Jurrie/Z99-development/Book/README.md

# Build Your Own Four-Axis Multifunctional Z99 CNC Machine

The Z99 is documented in the book ['Build Your Own Four-Axis Multifunctional Z99 CNC Machine'](https://www.elektormagazine.com/articles/build-your-own-4-axis-multifunctional-z99-cnc-machine) by José Ganseman.
It was published December 26th 2022 by Elektor magazine.

Please consider buying the book!
It is available as a [hard copy](https://www.elektor.com/tools/prototyping/etching-milling/build-your-own-multifunctional-4-axis-cnc-machine) or an [e-book](https://www.elektor.com/books/e-books/build-your-own-multifunctional-4-axis-cnc-machine-e-book).

These are the preview pages that are available on [Issuu](https://issuu.com/eimworld/docs/4-axis-cnc-machine-extract).
They were converted to images by using [IssuuDownload.com](https://issuudownload.com/eimworld/docs/4-axis-cnc-machine-extract).

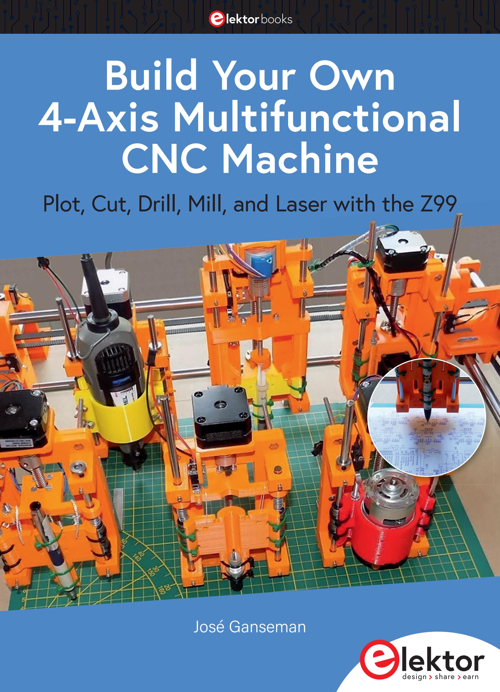
[picture p2: Book/page_01.jpg]




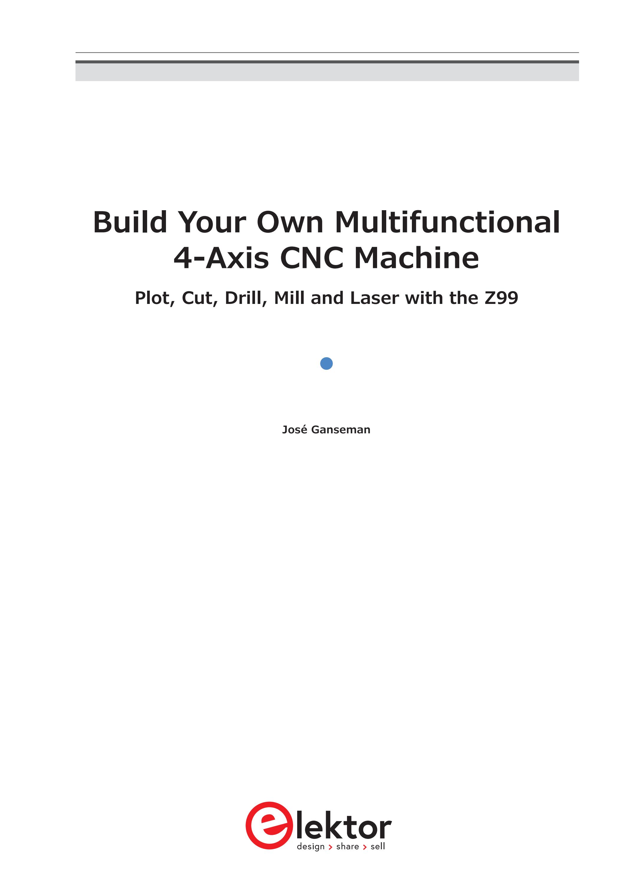
[picture p3: Book/page_03.jpg]


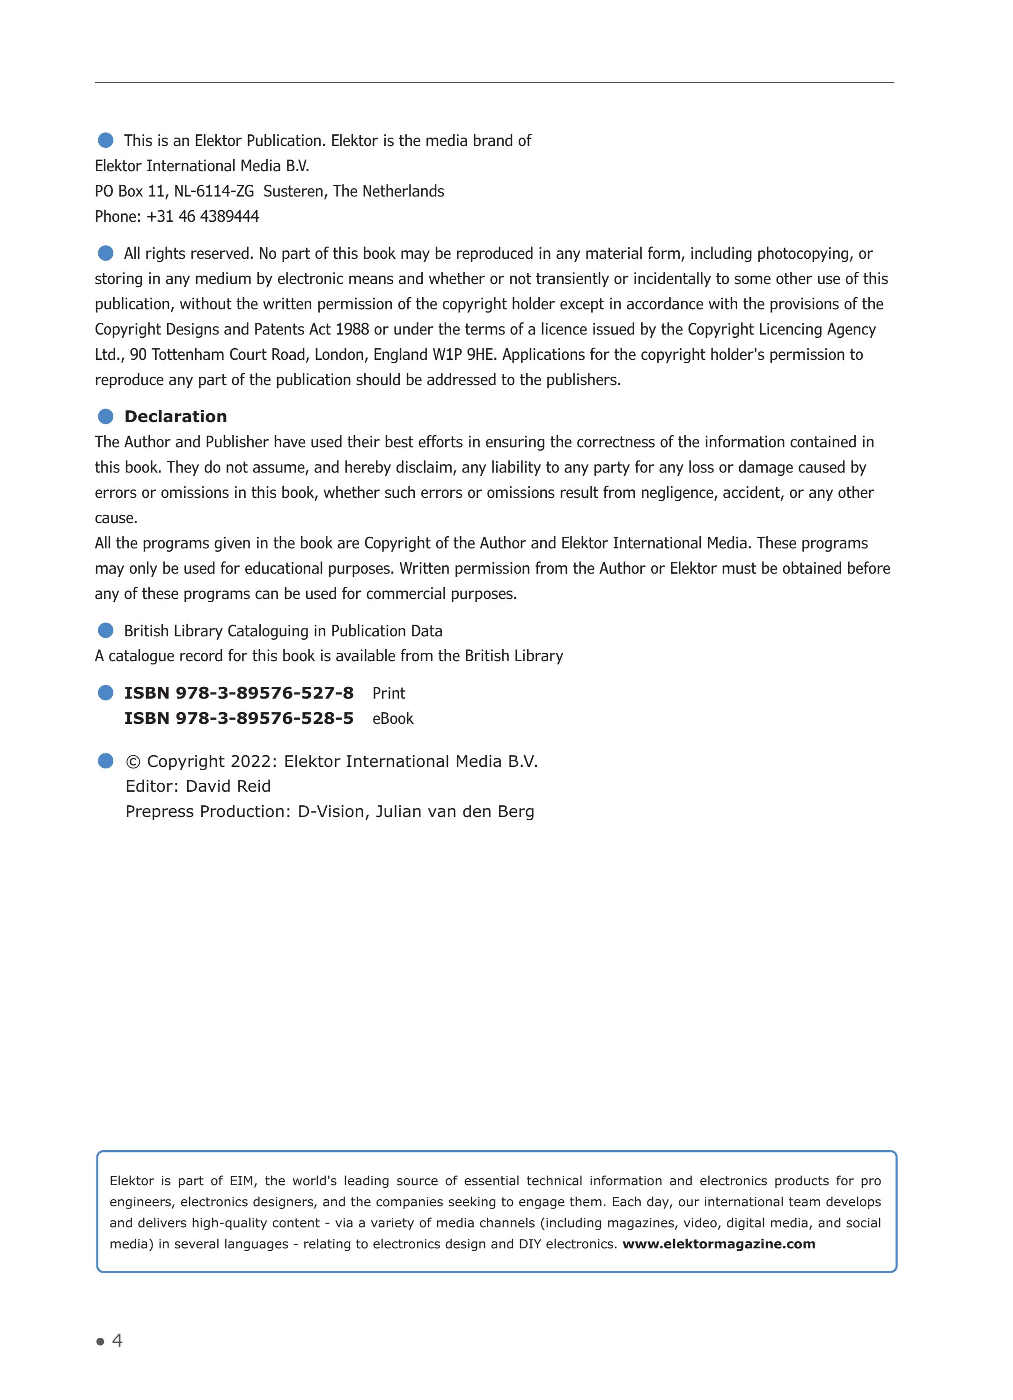
[picture p4: Book/page_04.jpg]


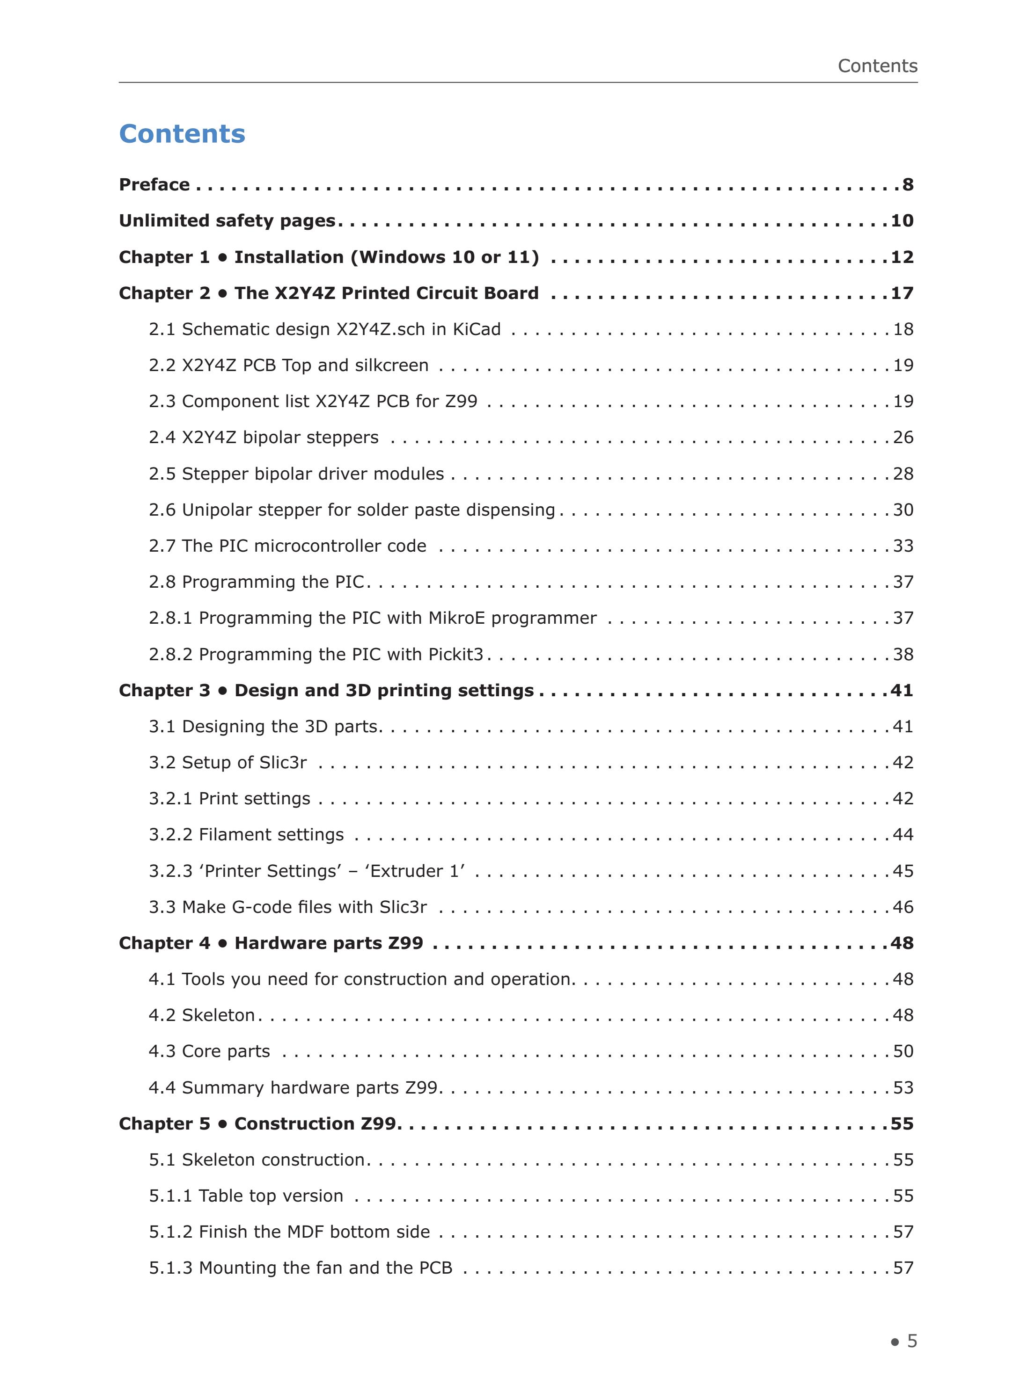
[picture p5: Book/page_05.jpg]


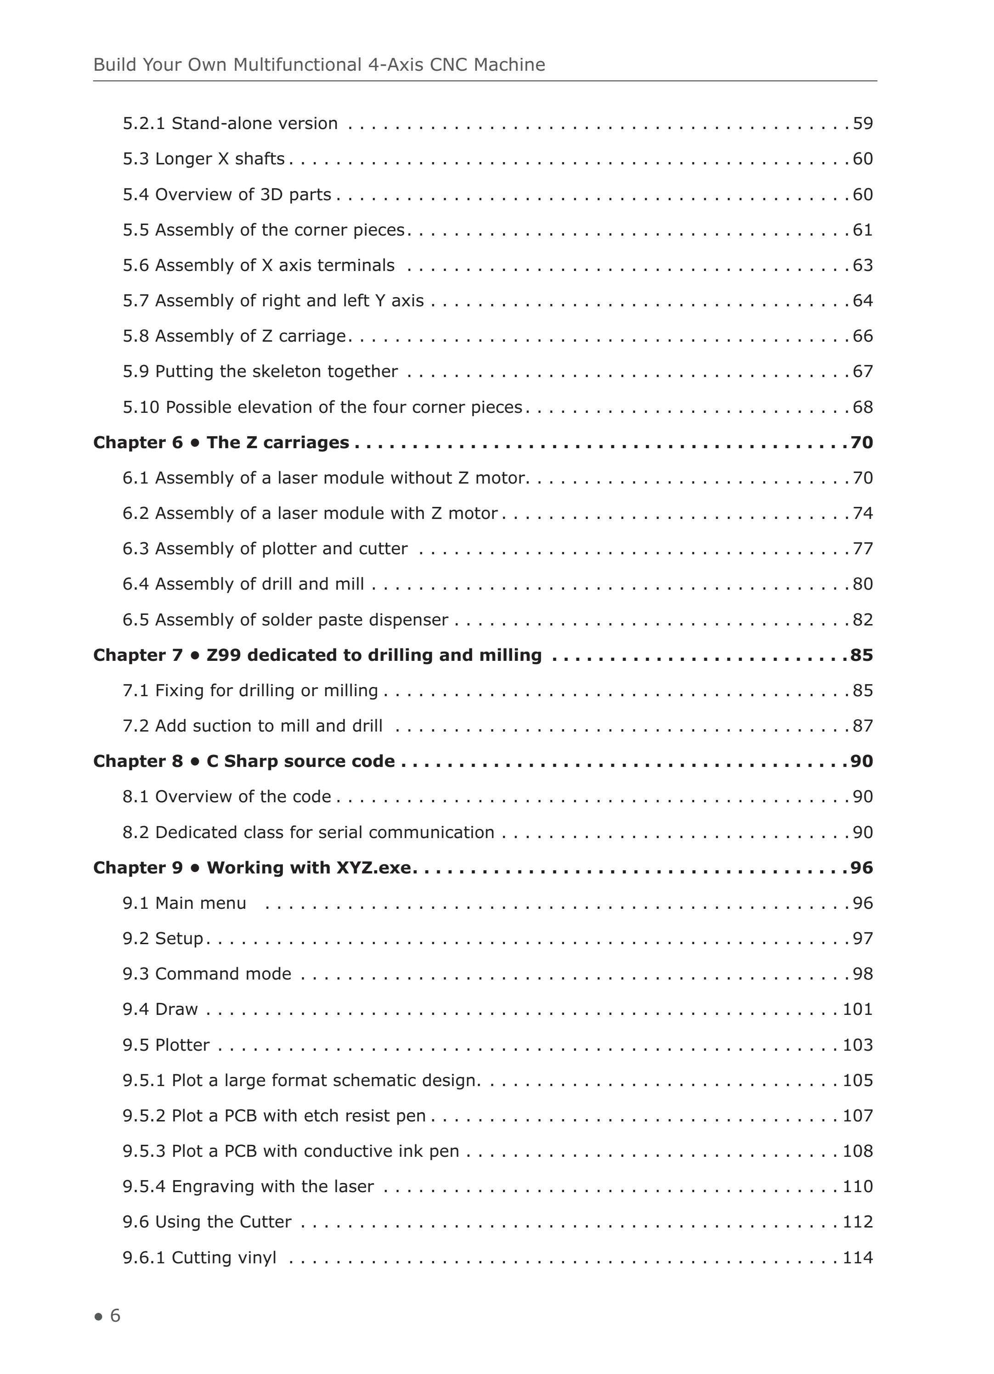
[picture p6: Book/page_06.jpg]


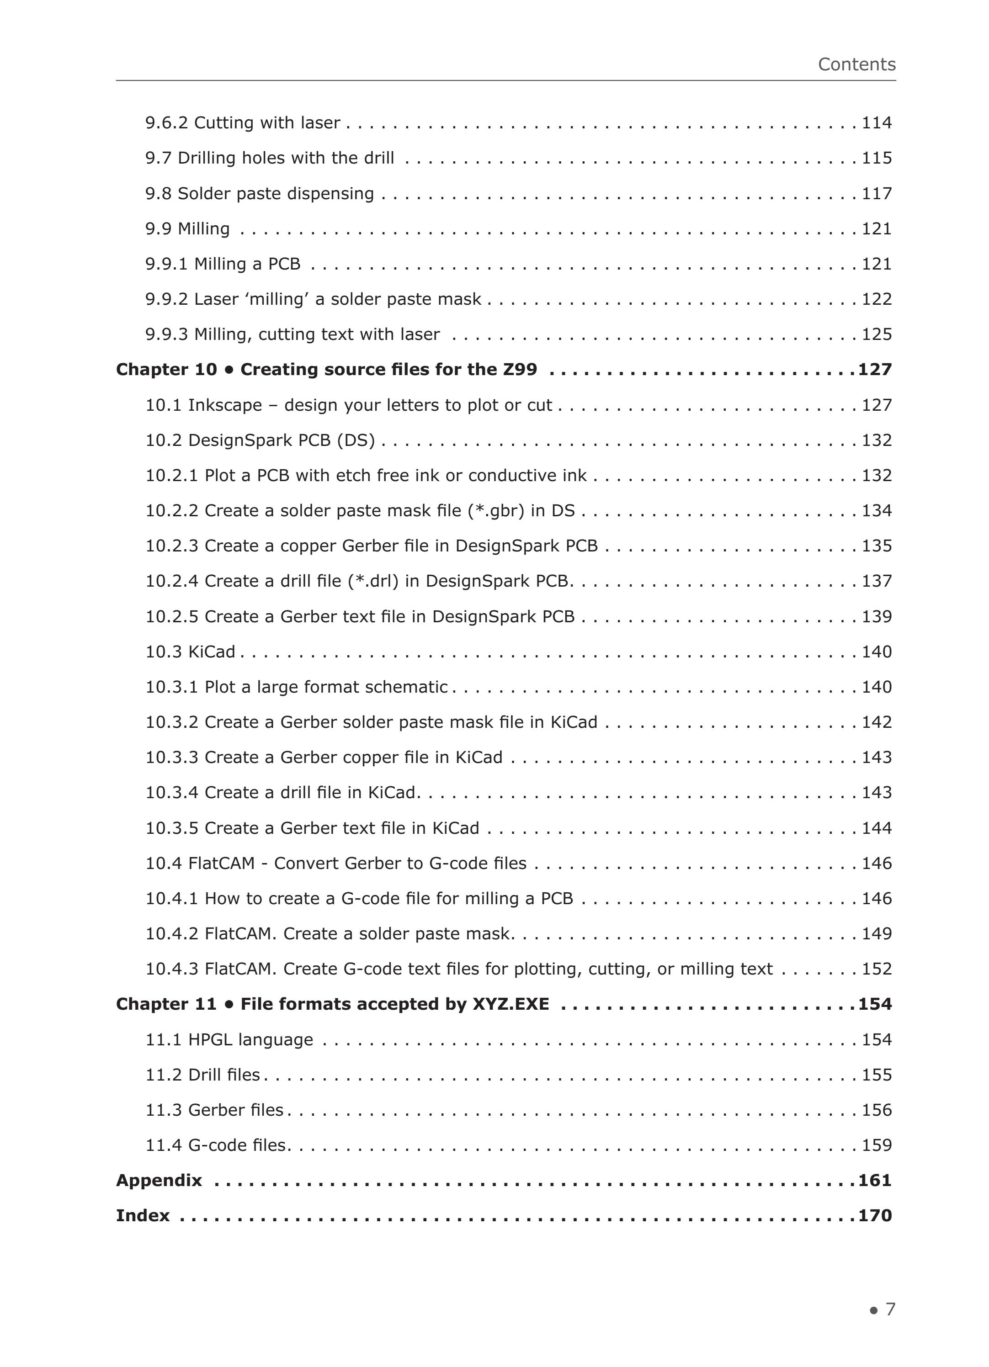
[picture p7: Book/page_07.jpg]


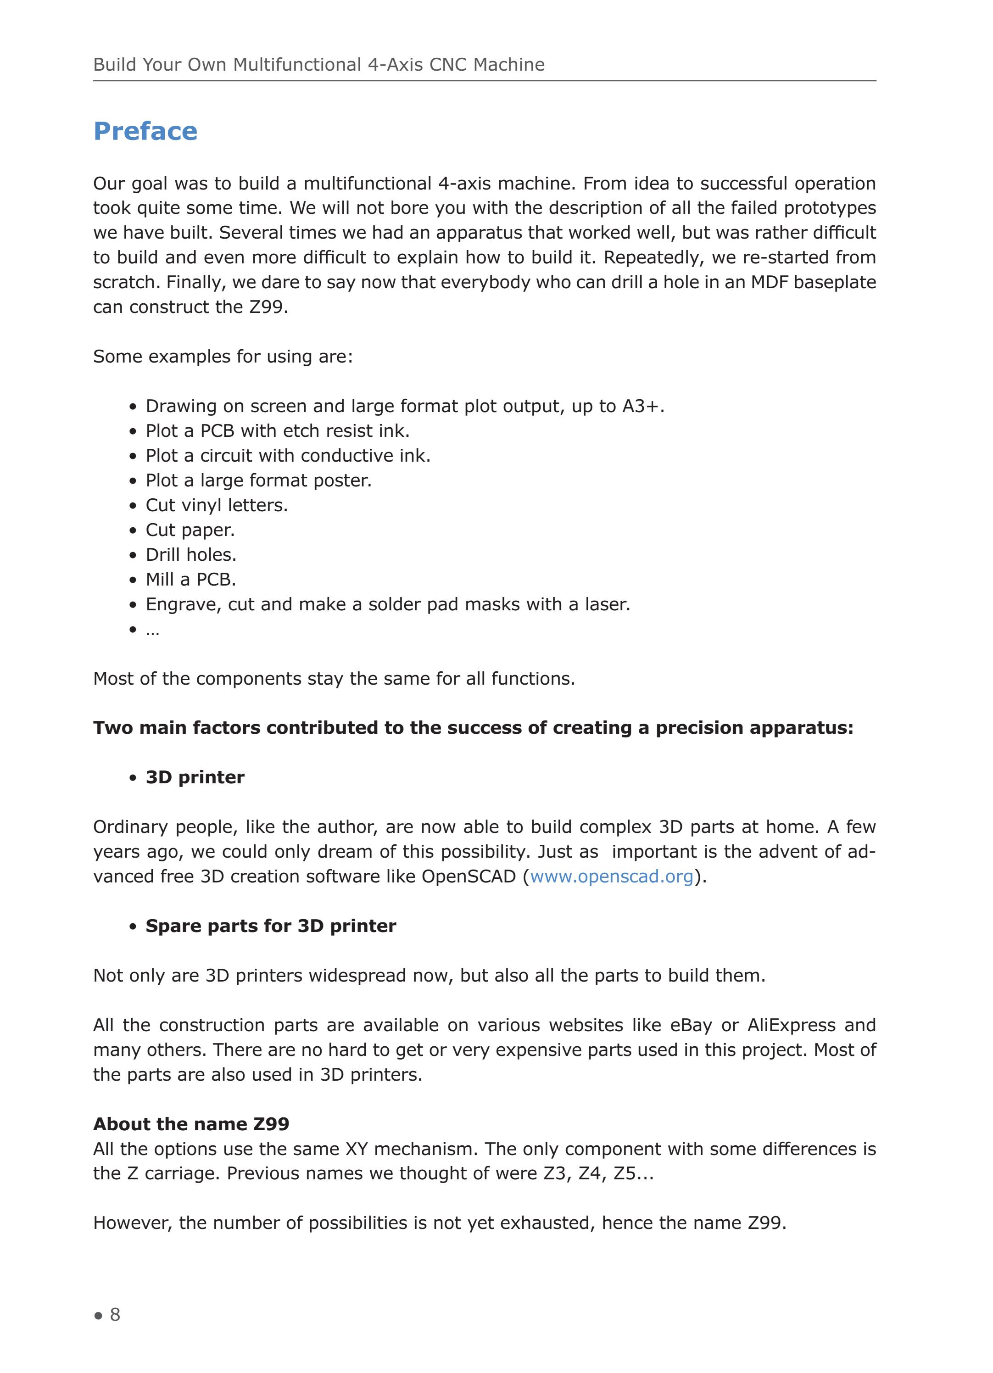
[picture p8: Book/page_08.jpg]


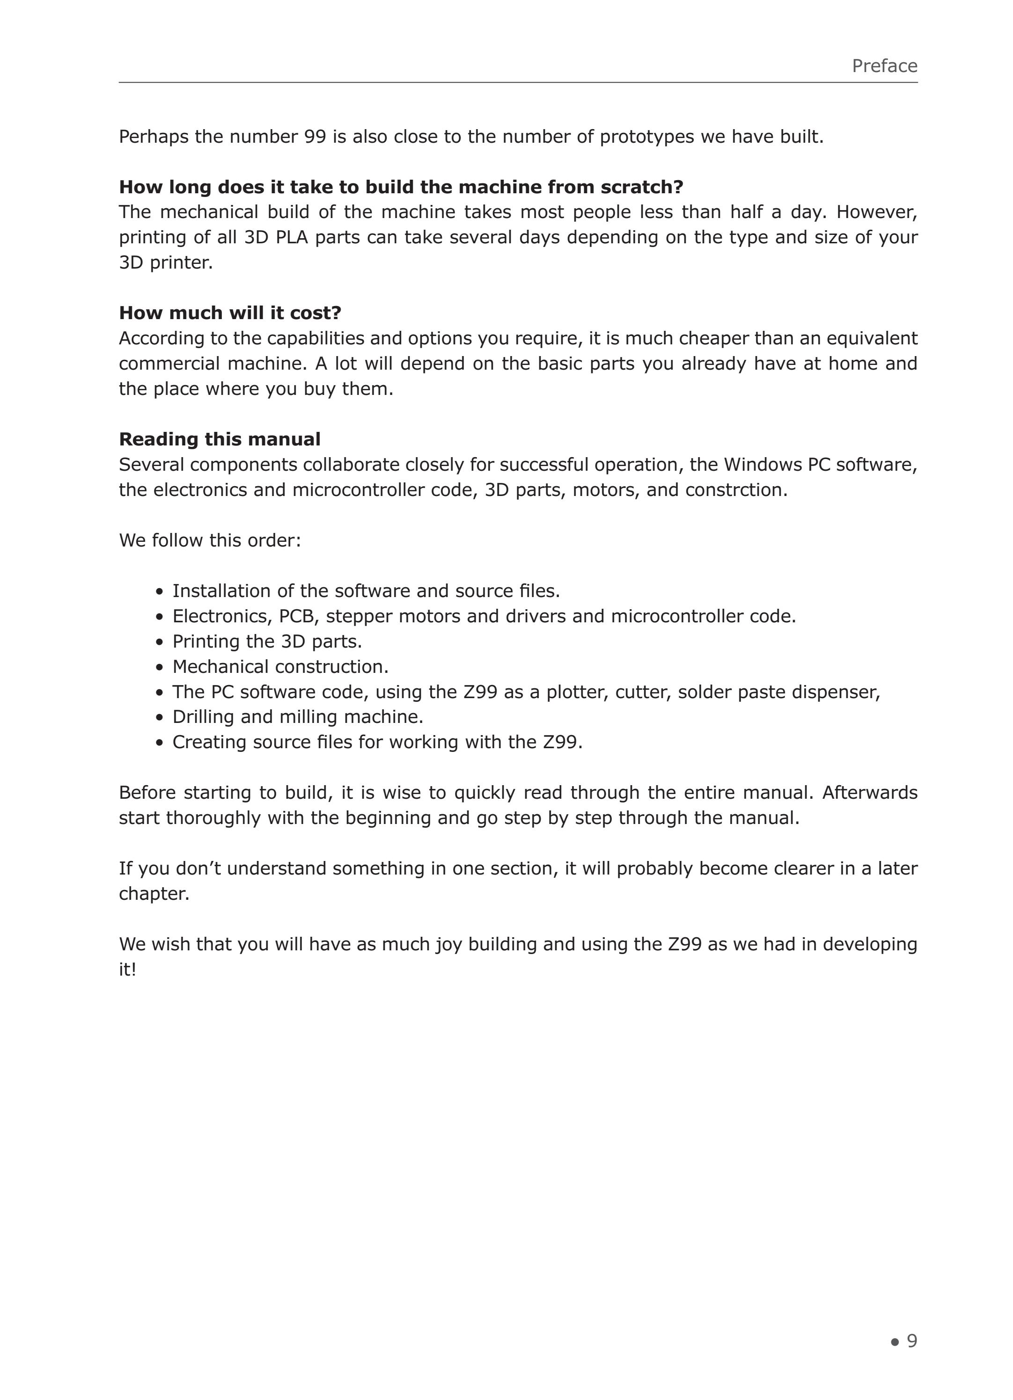
[picture p9: Book/page_09.jpg]


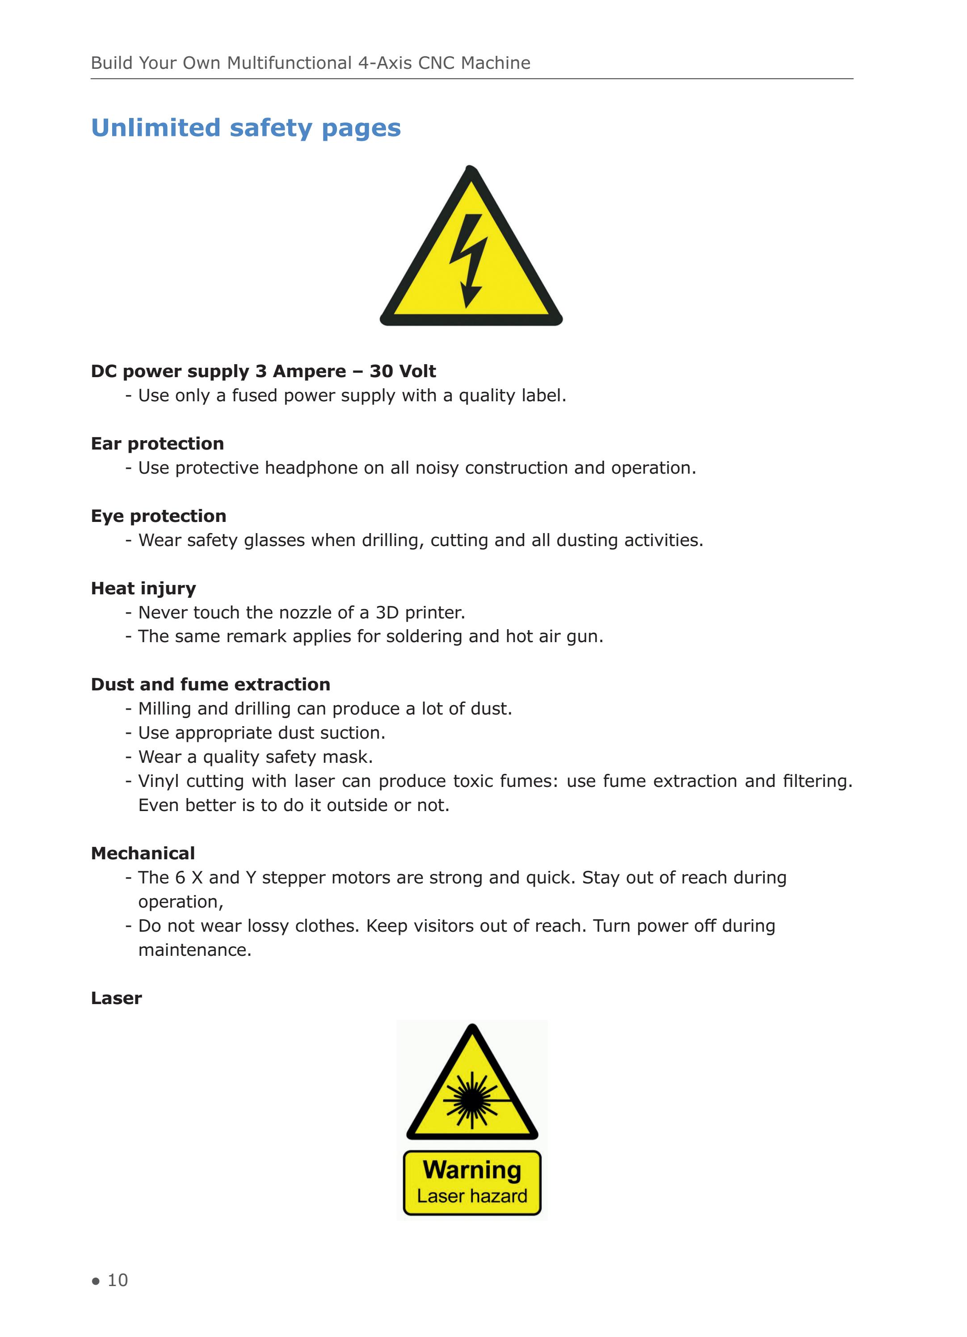
[picture p10: Book/page_10.jpg]


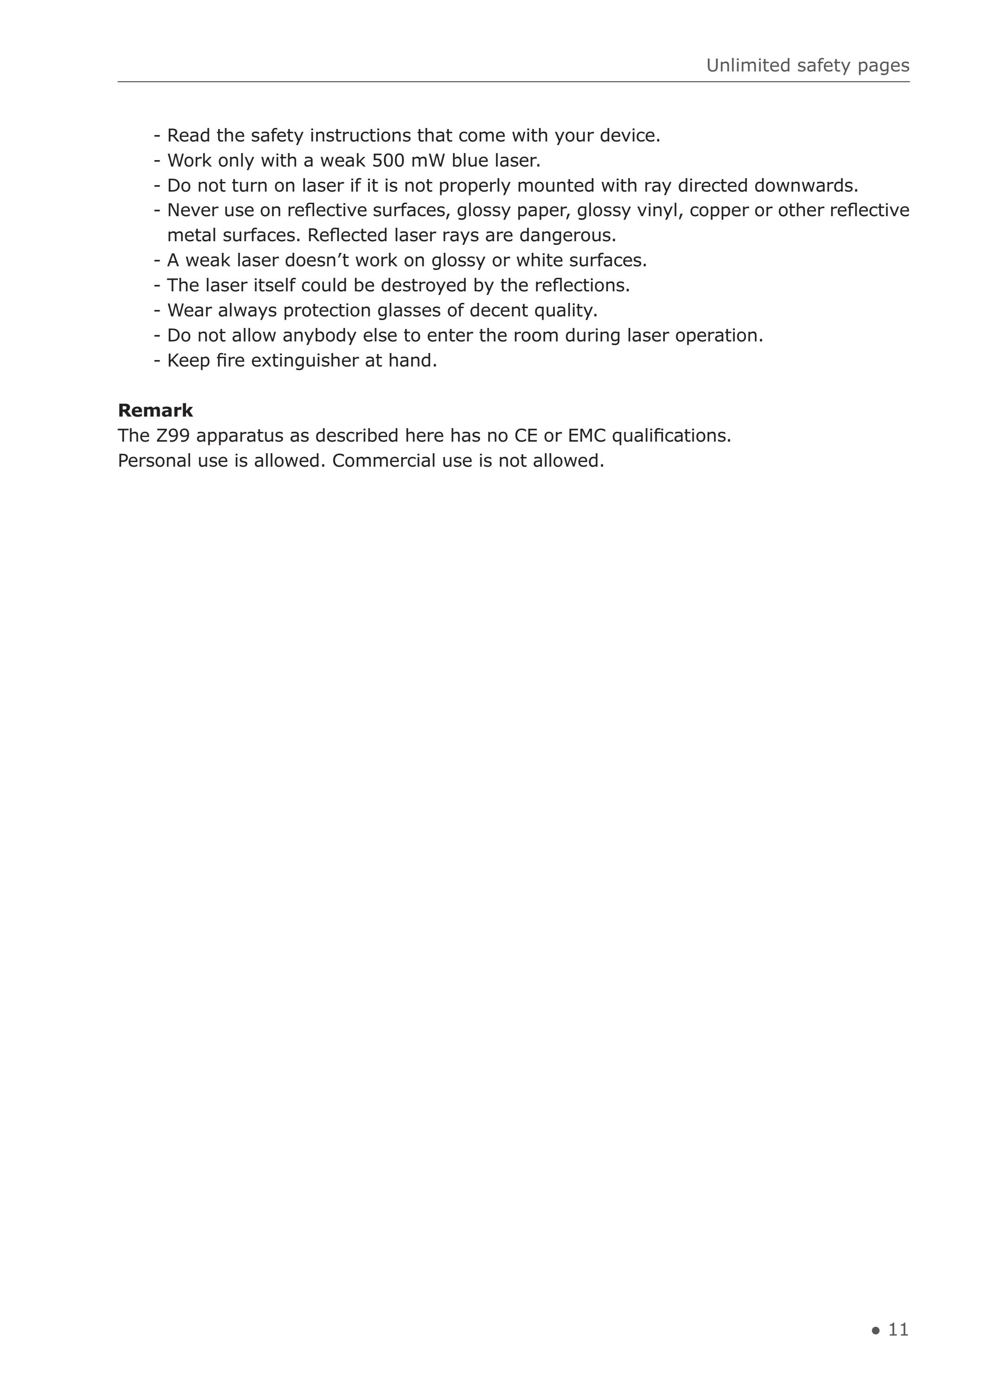
[picture p11: Book/page_11.jpg]


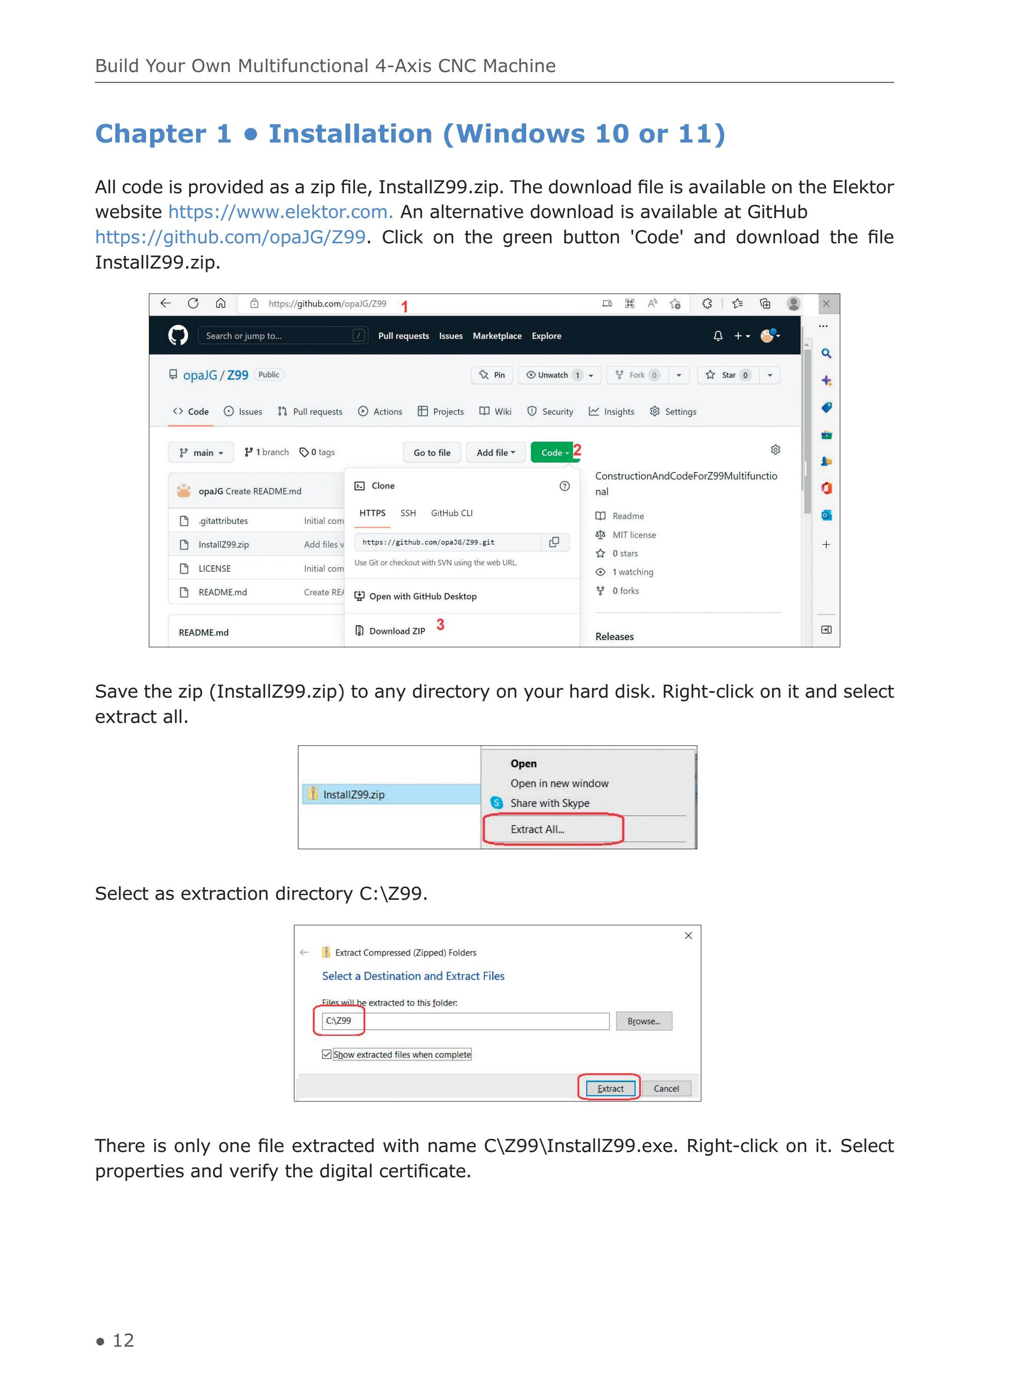
[picture p12: Book/page_12.jpg]


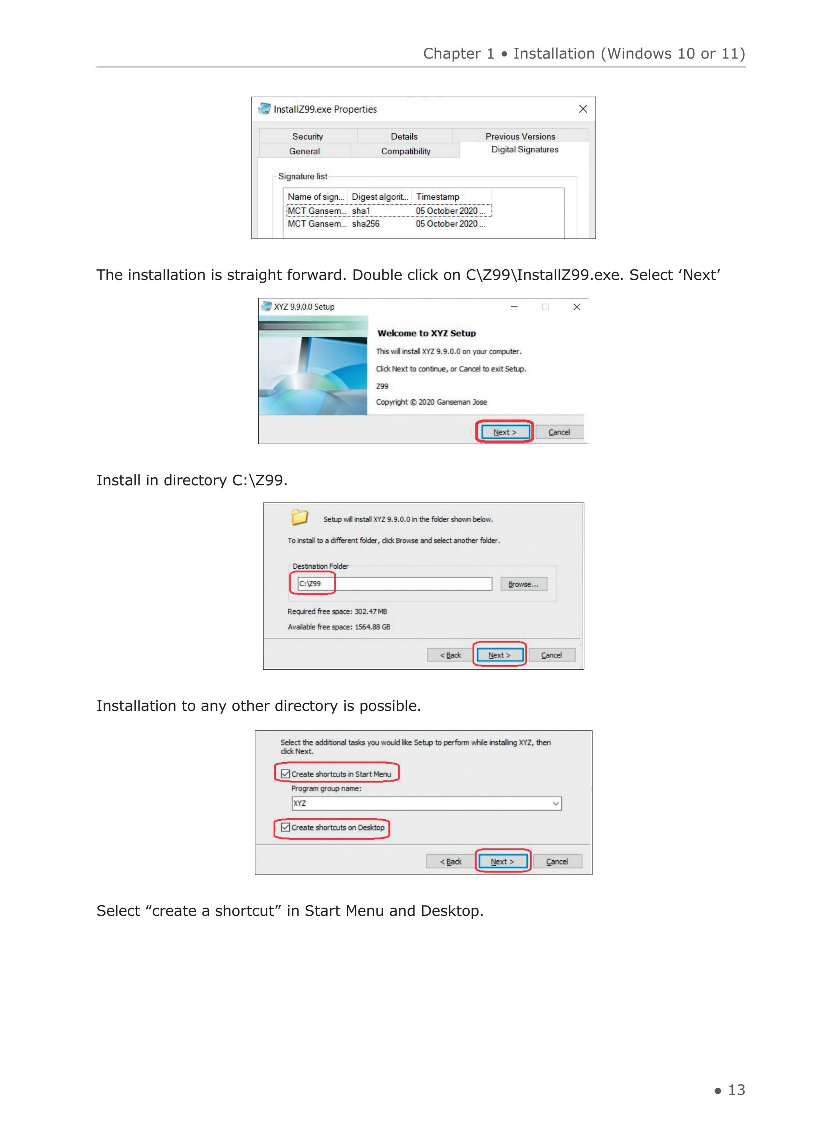
[picture p13: Book/page_13.jpg]


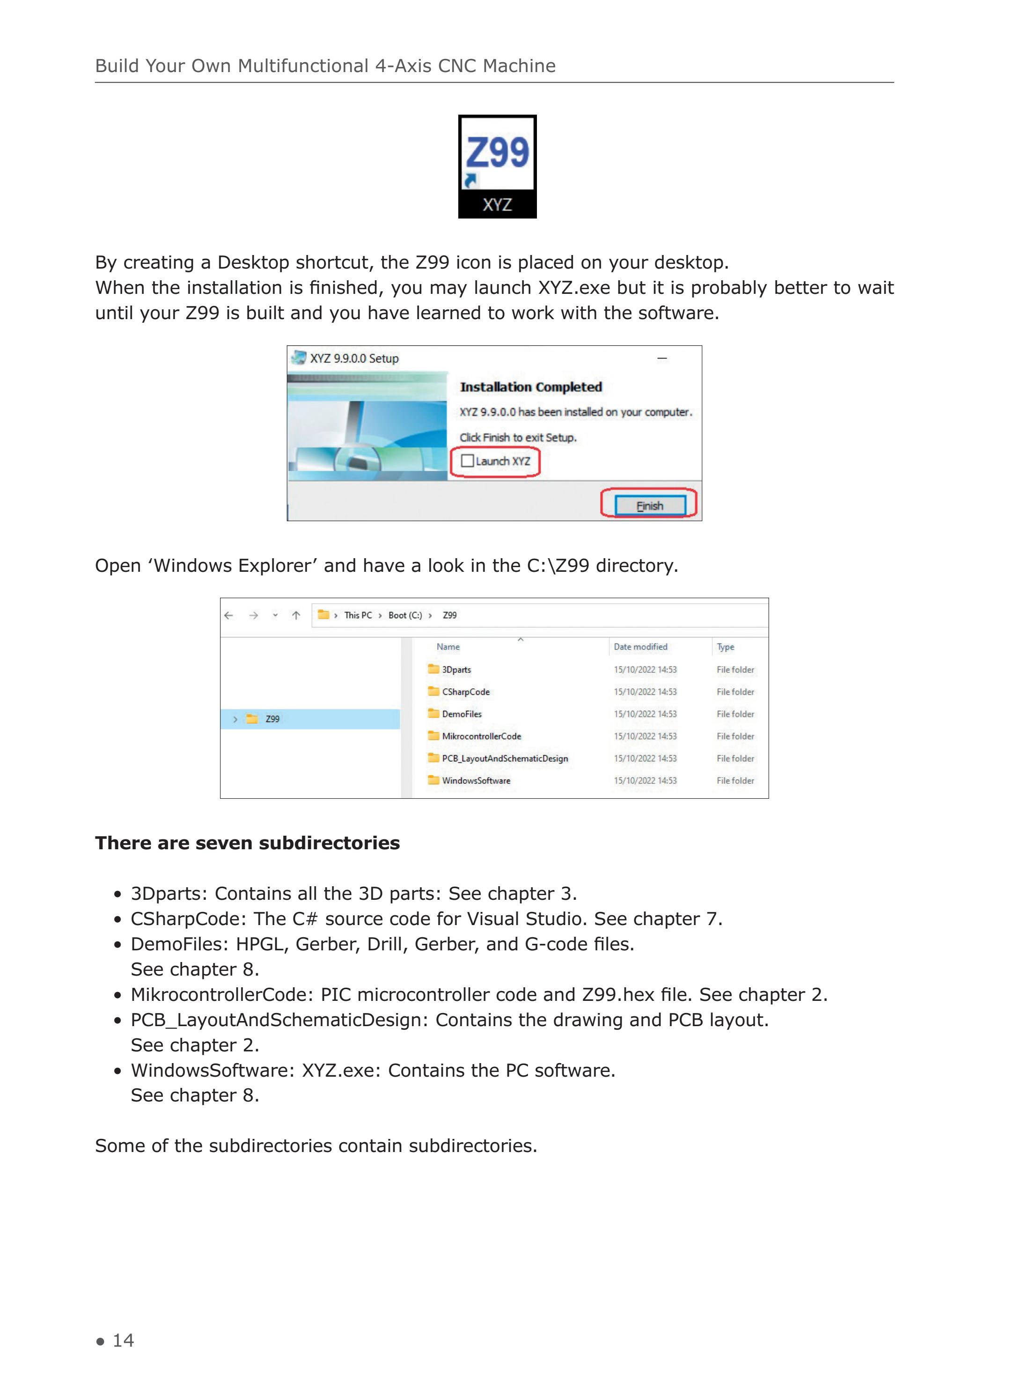
[picture p14: Book/page_14.jpg]


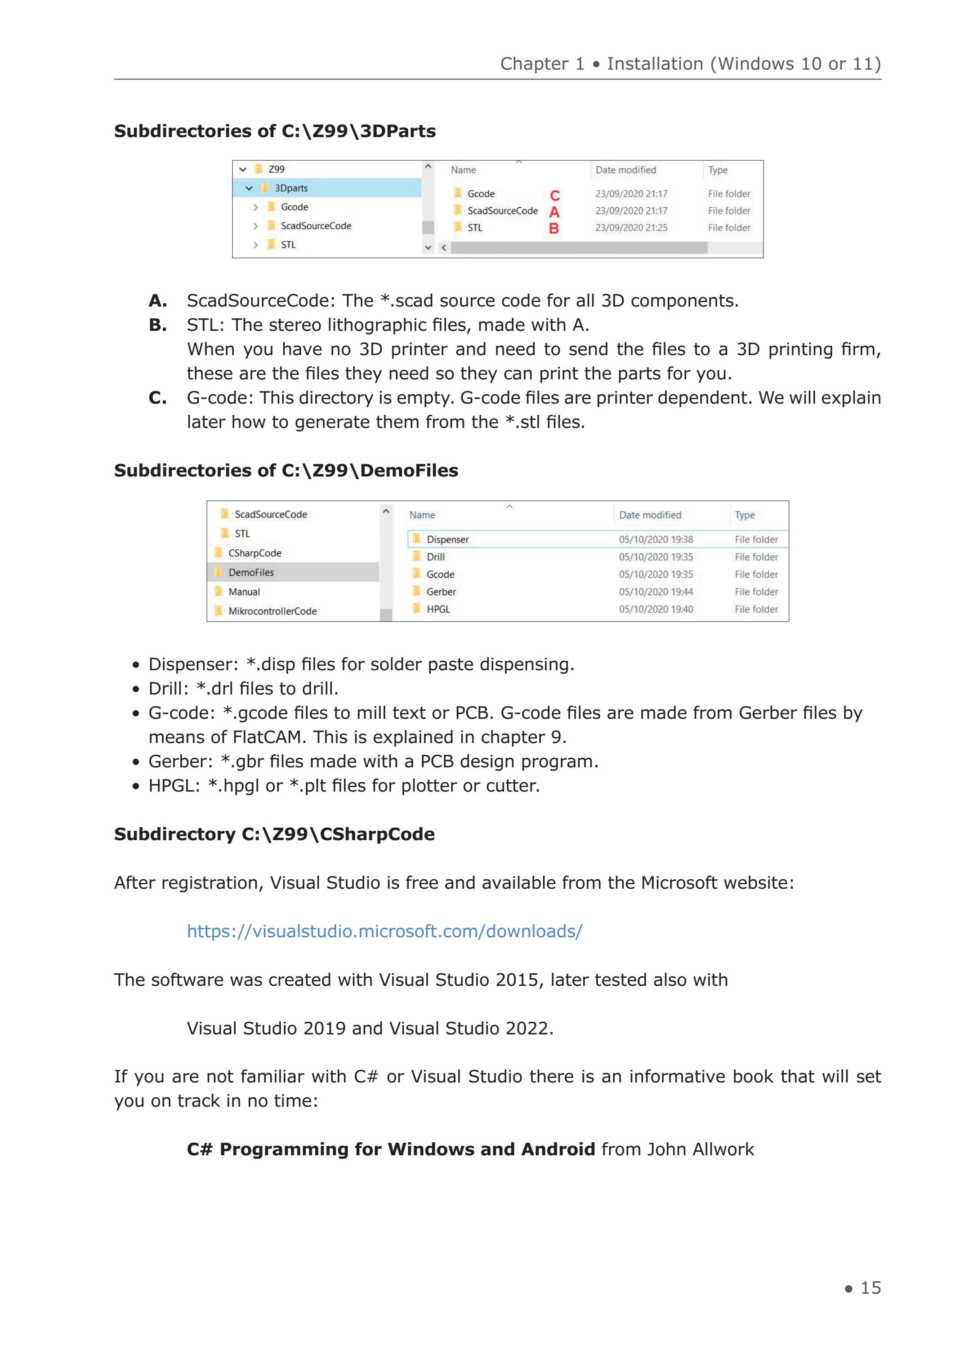
[picture p15: Book/page_15.jpg]


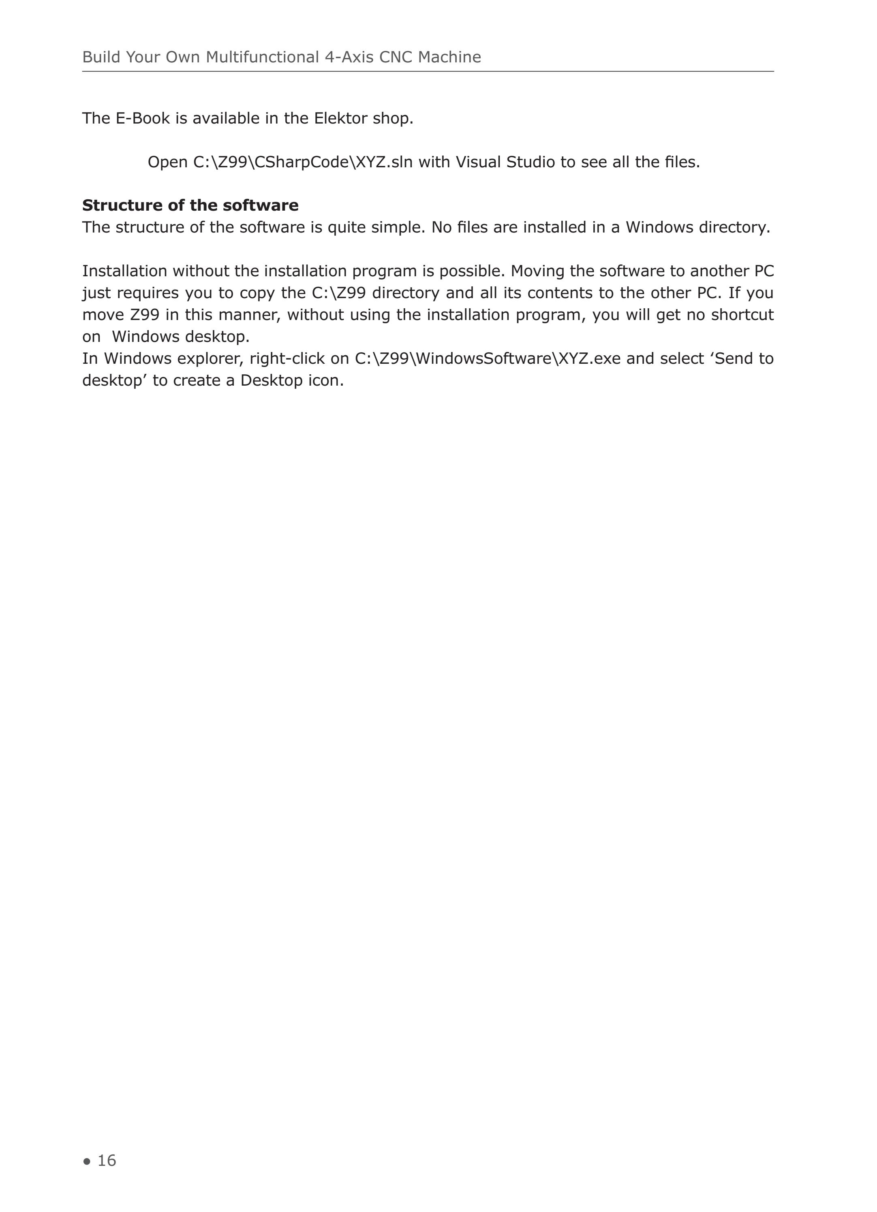
[picture p16: Book/page_16.jpg]


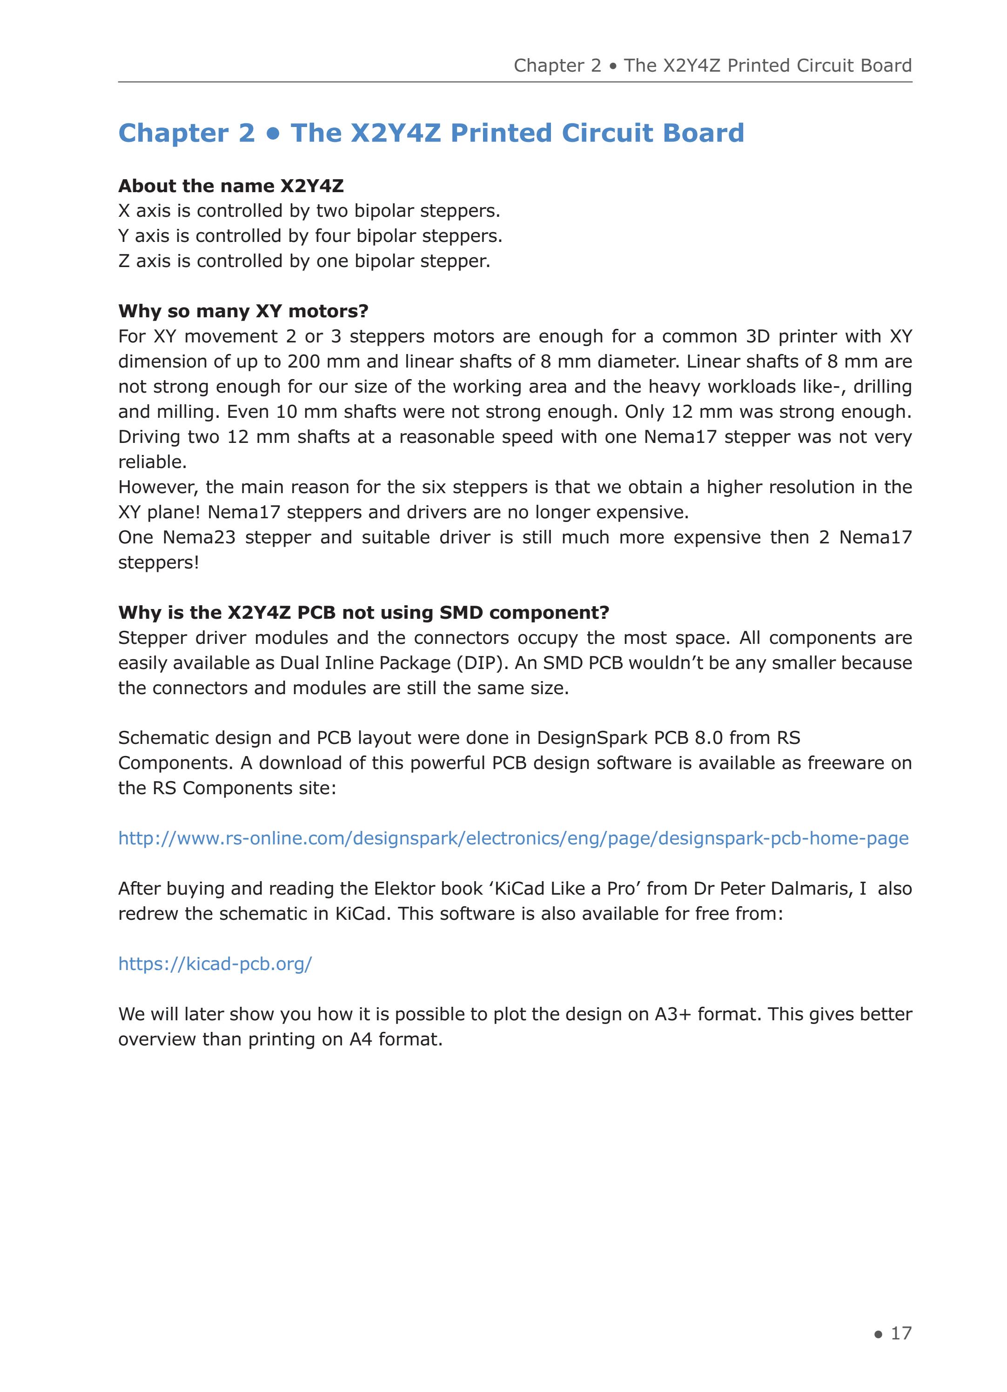
[picture p17: Book/page_17.jpg]


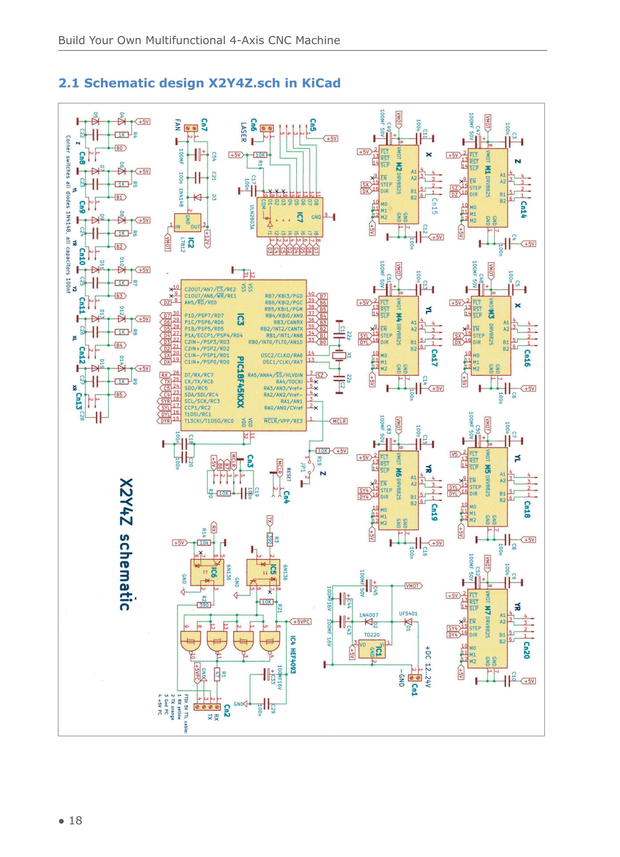
[picture p18: Book/page_18.jpg]


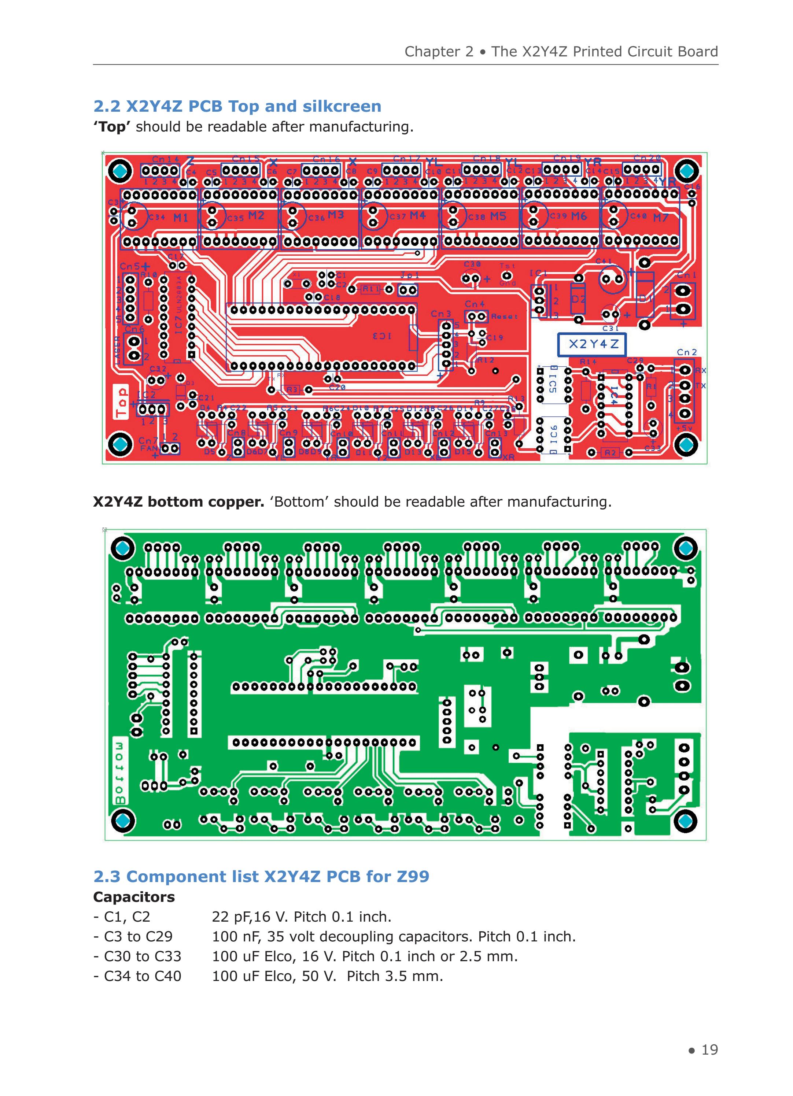
[picture p19: Book/page_19.jpg]


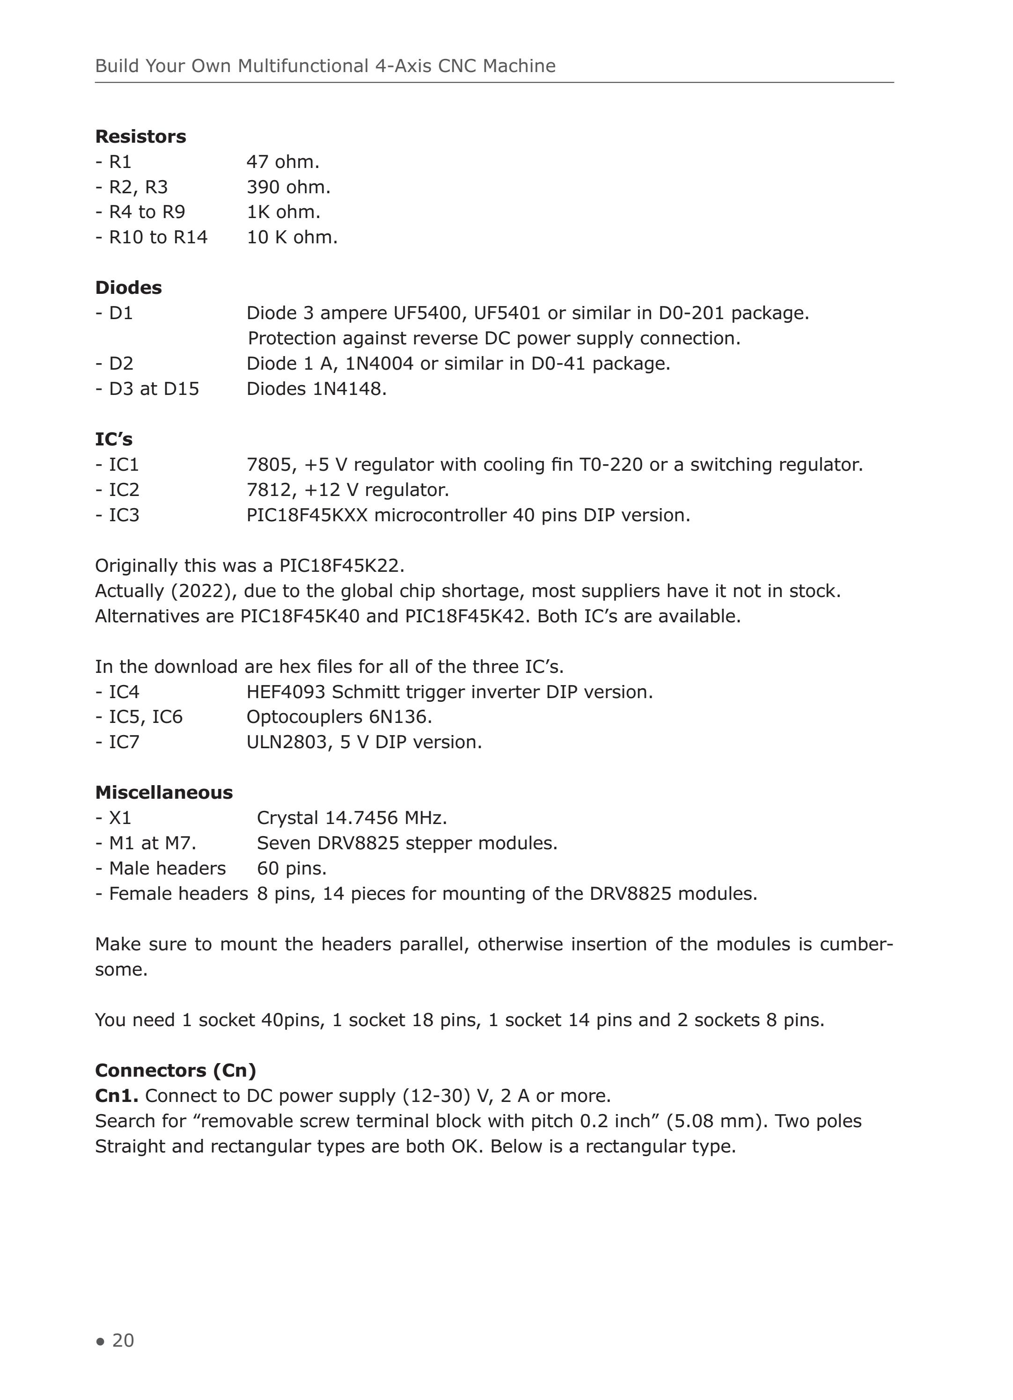
[picture p20: Book/page_20.jpg]


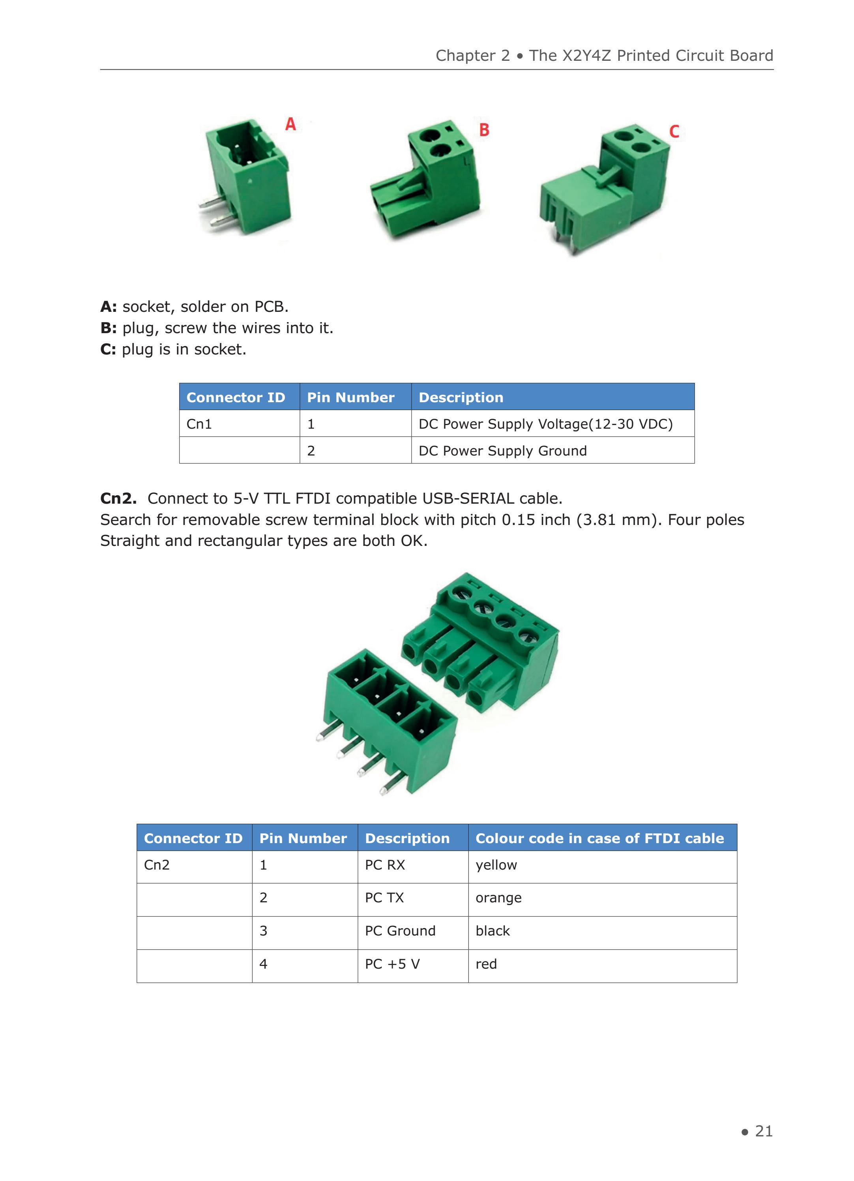
[picture p21: Book/page_21.jpg]


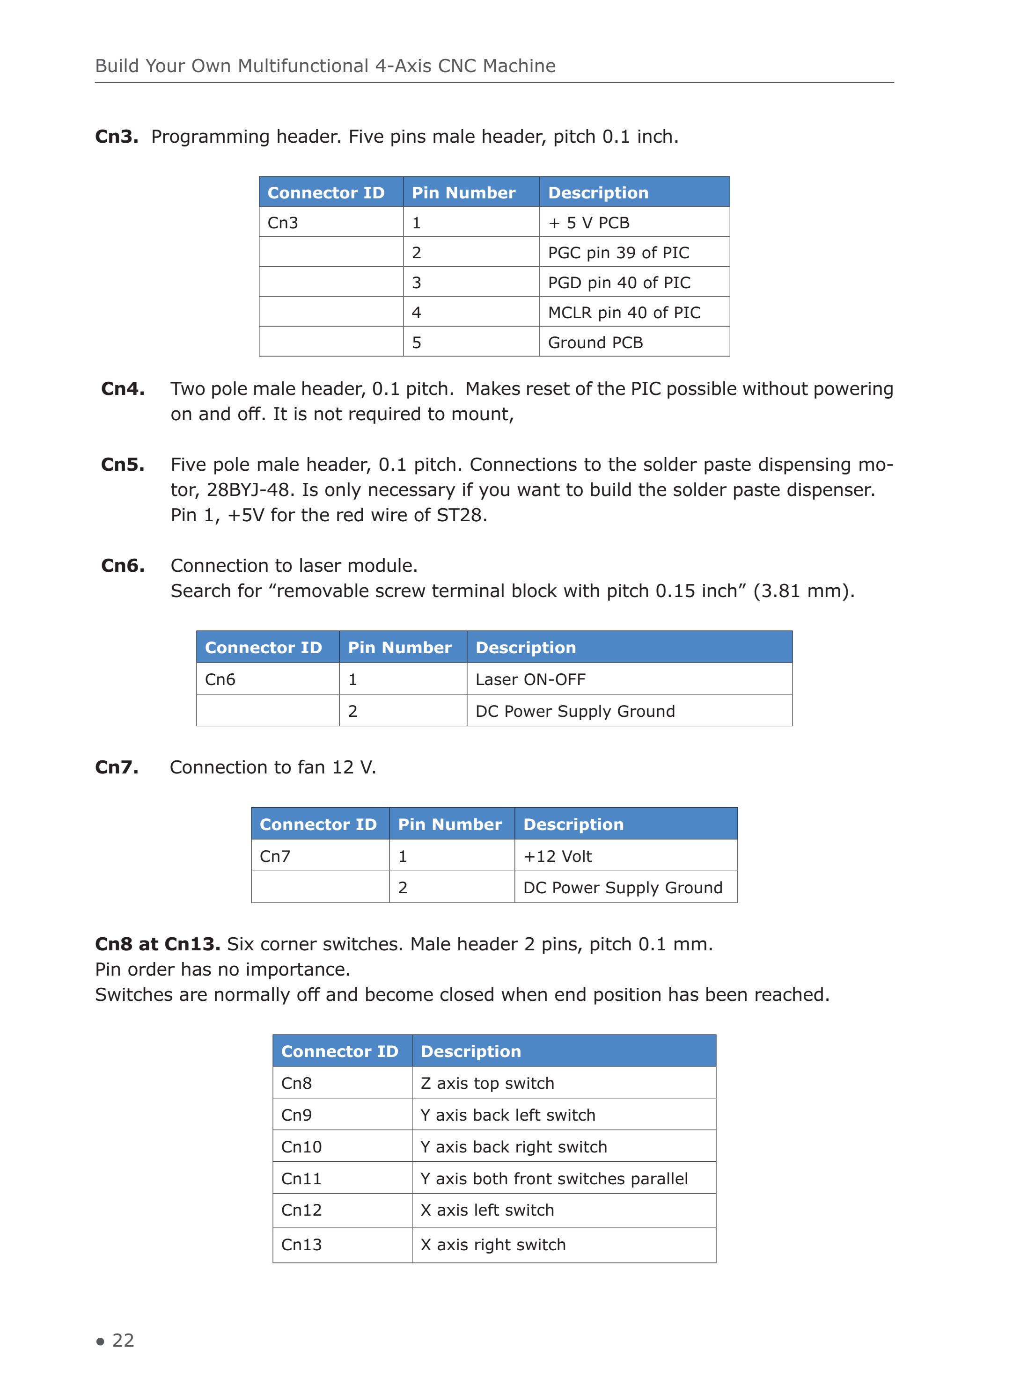
[picture p22: Book/page_22.jpg]


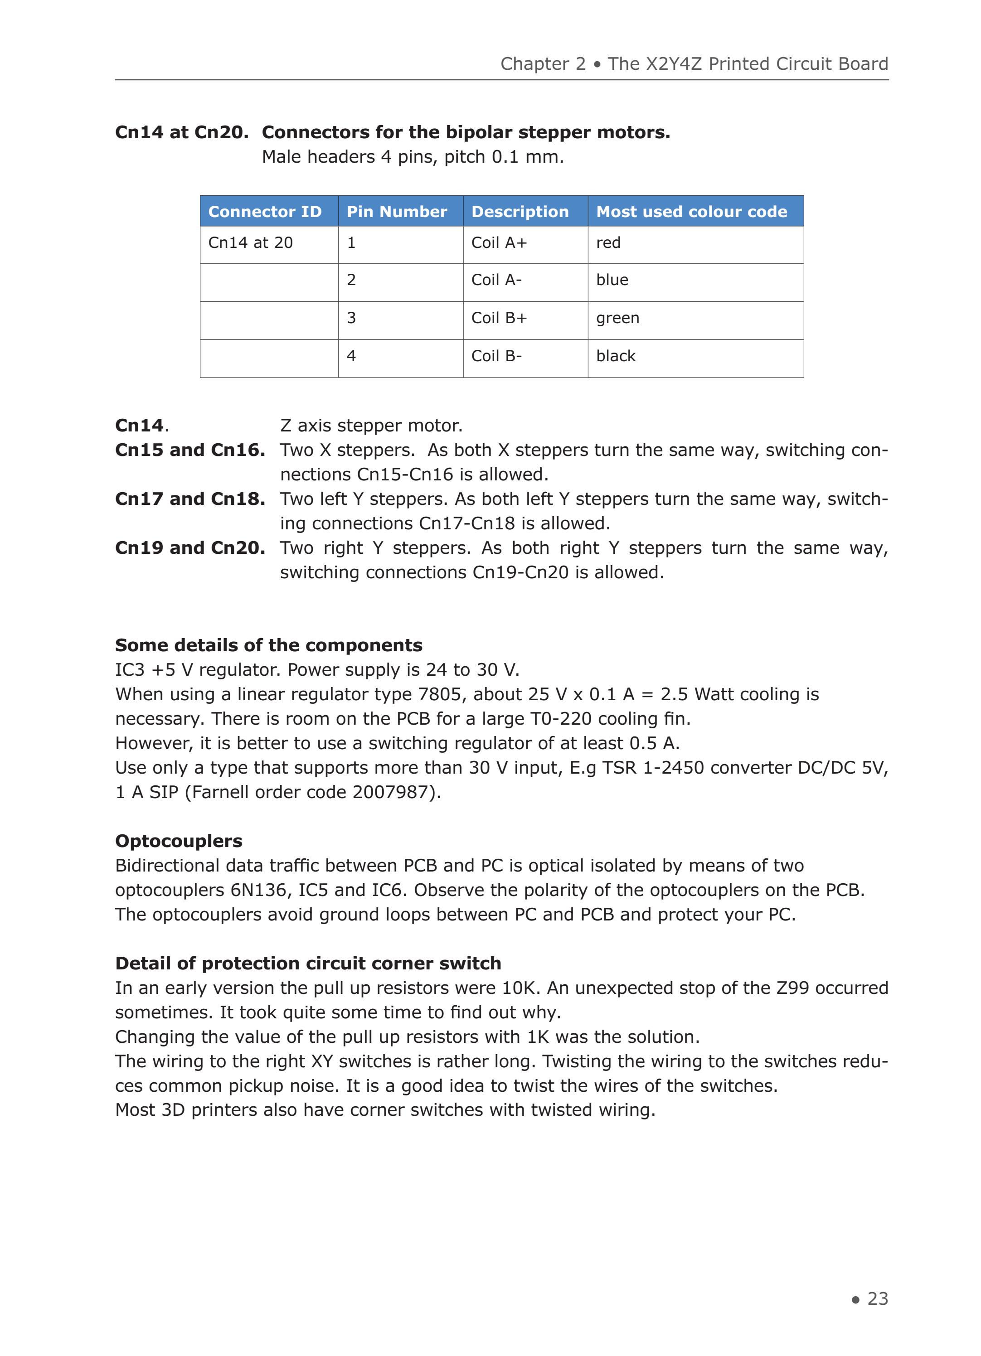
[picture p23: Book/page_23.jpg]


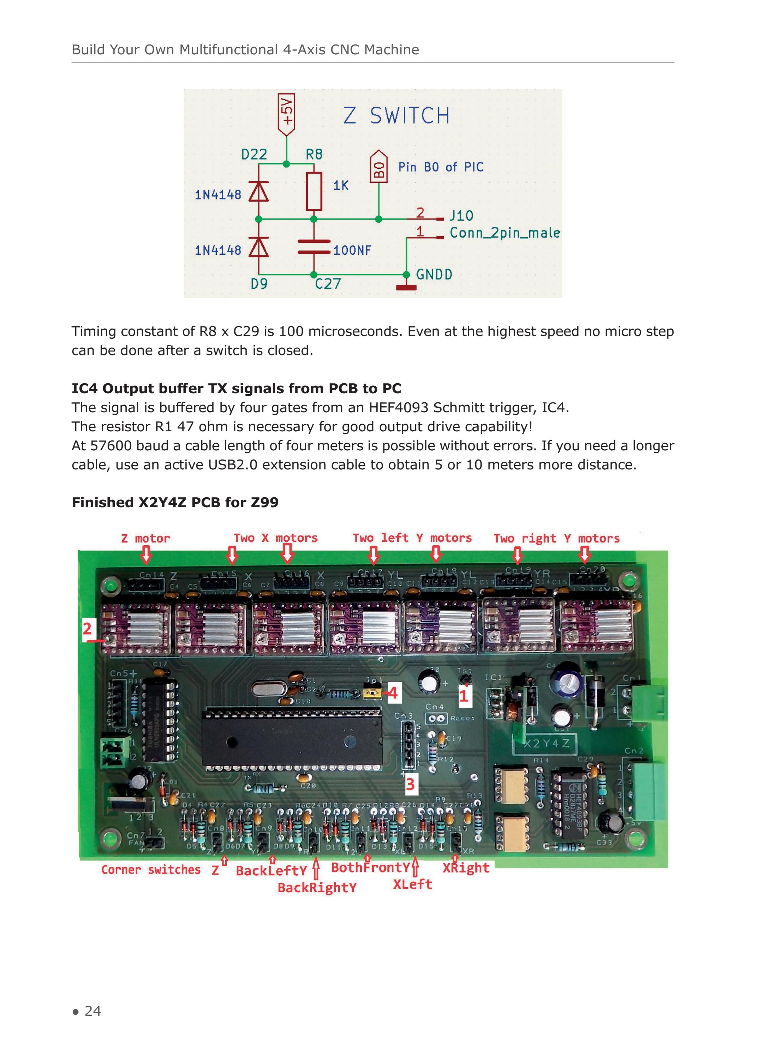
[picture p24: Book/page_24.jpg]


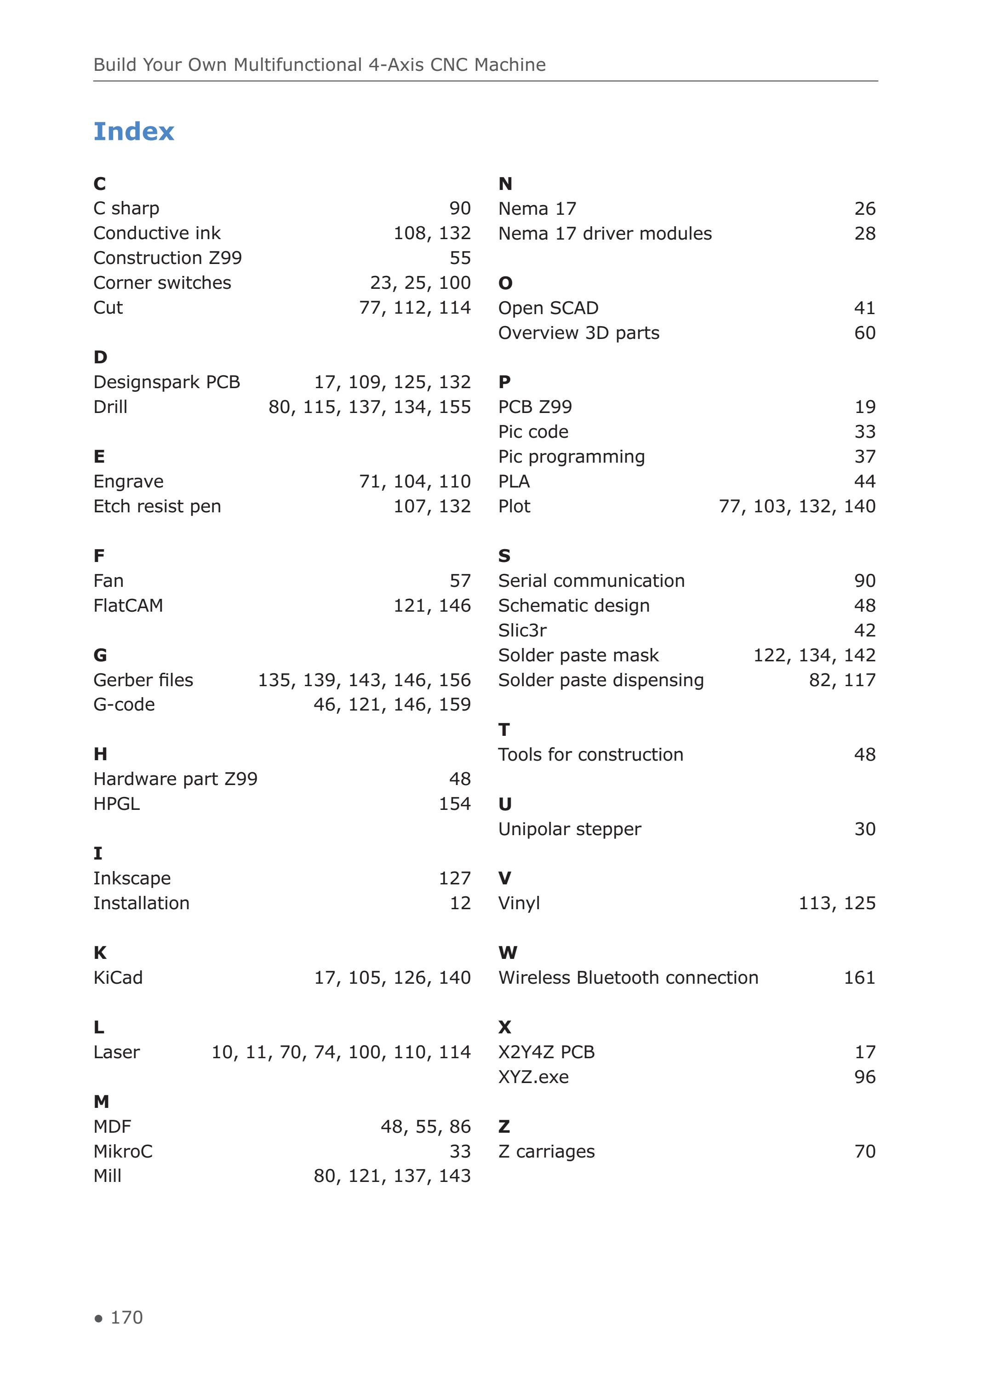
[picture p25: Book/page_25.jpg]


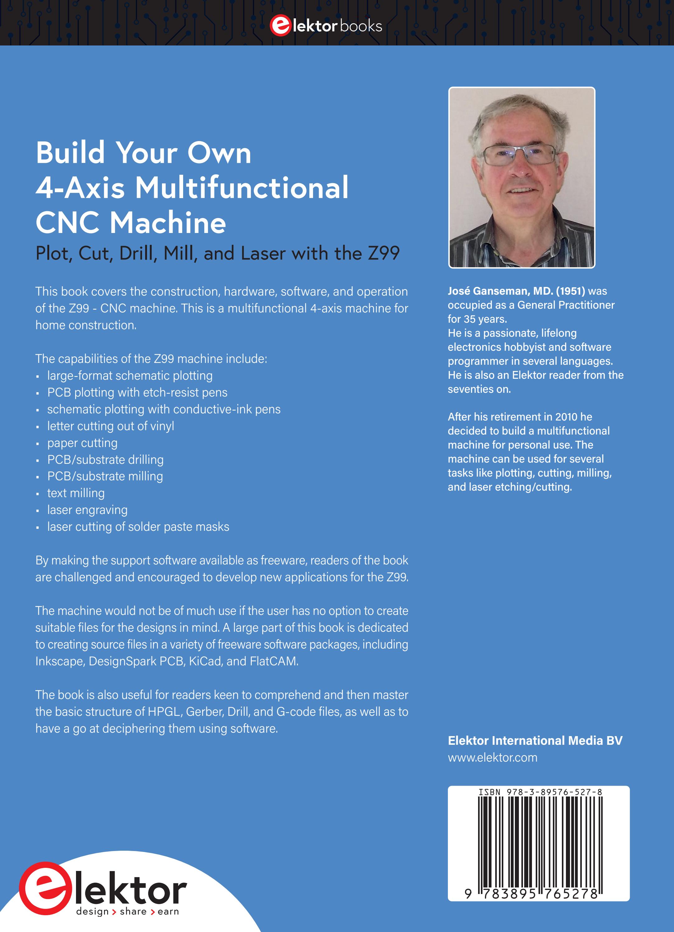
[picture p26: Book/page_26.jpg]
