Jurrie/Z99-development/DemoFiles/HPGL/ElephantModel.jpg

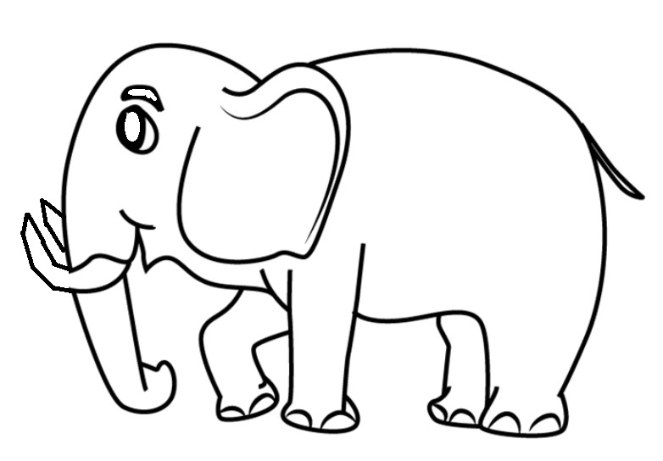
DemoFiles/HPGL/ElephantModel.jpg
