Jurrie/Z99-development/3Dparts/STL/CommonParts/RightTerminalXUp.stl

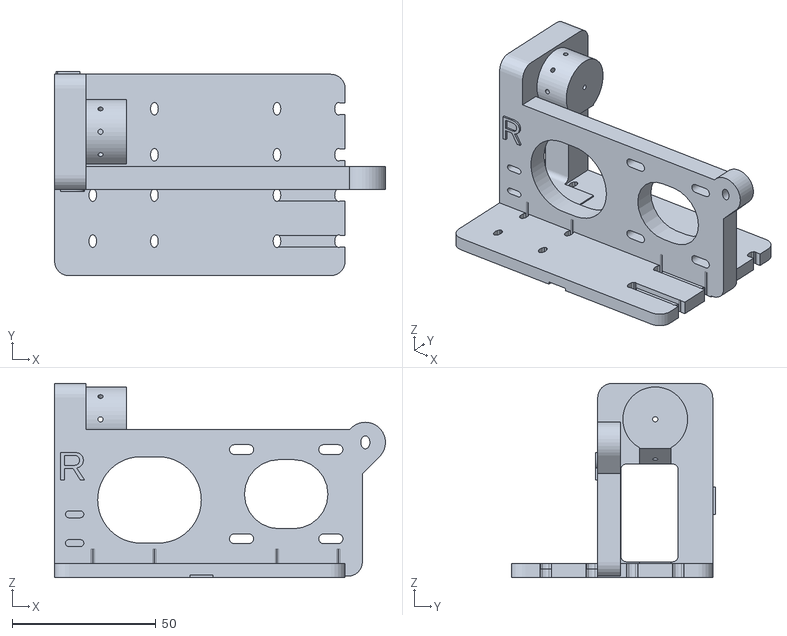
[picture p28: CAD file, 2023-03-07]
3Dparts/STL/CommonParts/RightTerminalXUp.stl
115.0 x 71.0 x 67.5
