Jurrie/Z99-development/3Dparts/STL/ConstructionAid/Z99CornerAid.stl

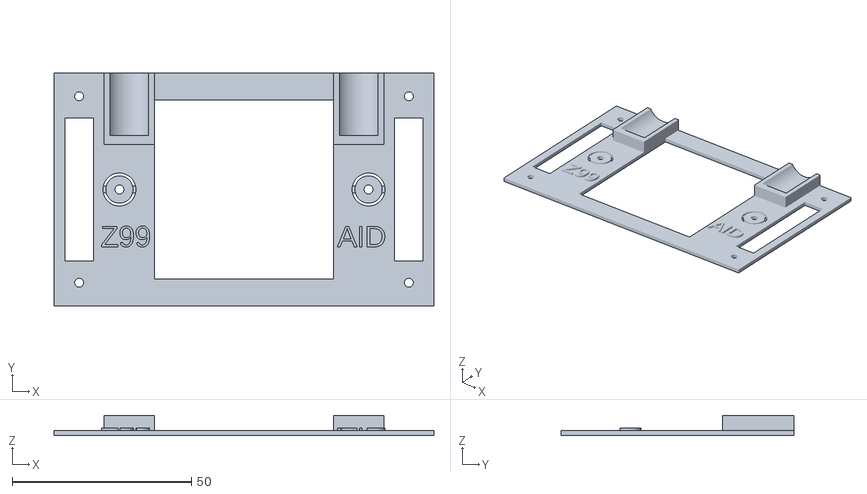
[picture p29: CAD file, 2023-03-07]
3Dparts/STL/ConstructionAid/Z99CornerAid.stl
106.0 x 65.0 x 5.70
