Jurrie/Z99-development/3Dparts/STL/Various/Elevations/Elevation10mm.stl

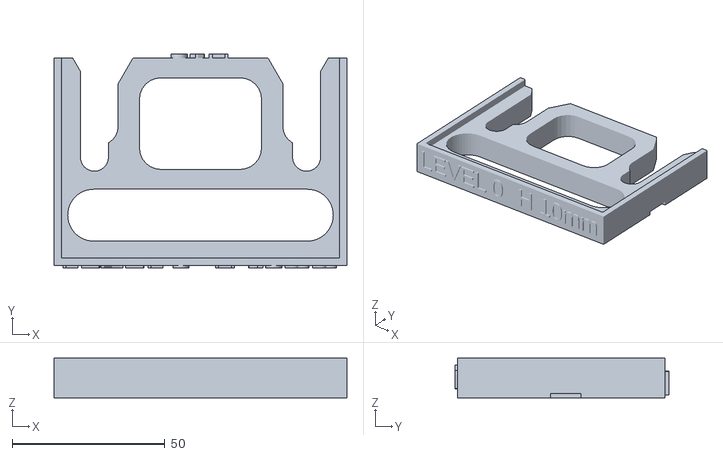
[picture p30: CAD file, 2023-03-07]
3Dparts/STL/Various/Elevations/Elevation10mm.stl
96.0 x 70.0 x 13.0
