Jurrie/Z99-development/3Dparts/STL/Various/LM12LM6Bearings/LM6UU.stl

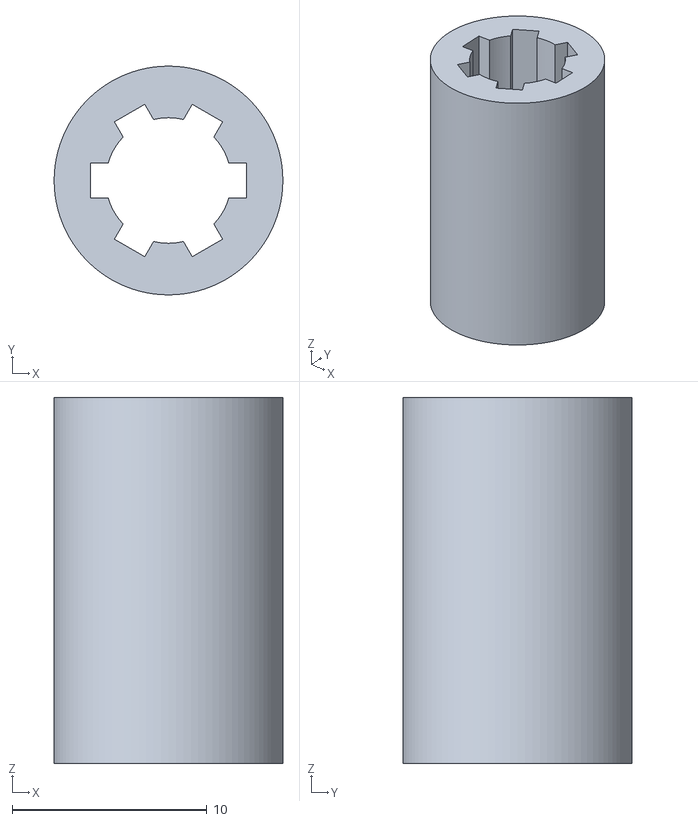
[picture p31: CAD file, 2023-03-07]
3Dparts/STL/Various/LM12LM6Bearings/LM6UU.stl
11.8 x 11.8 x 18.8
