Jurrie/Z99-development/3Dparts/STL/Various/Spacers/SpacerM8L30.stl

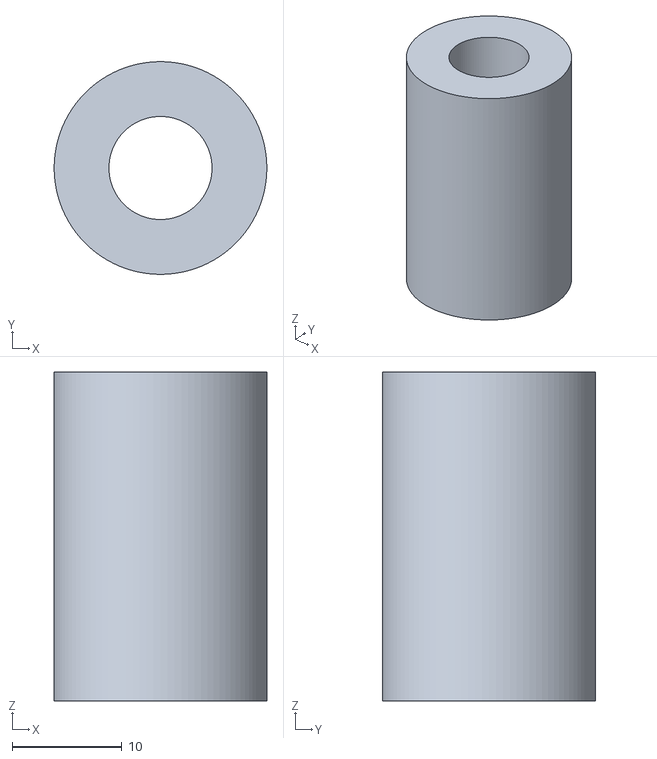
[picture p32: CAD file, 2023-03-07]
3Dparts/STL/Various/Spacers/SpacerM8L30.stl
19.4 x 19.4 x 30.0
