Jurrie/Z99-development/3Dparts/STL/ZCarriage/Cutter/CutterOrPenHolder.stl

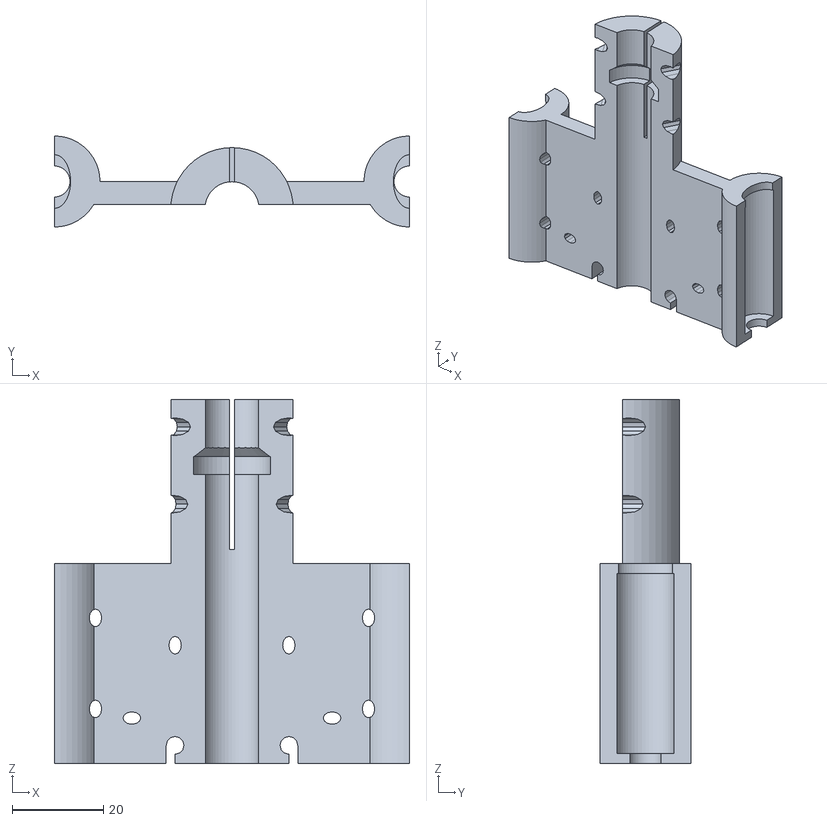
[picture p33: CAD file, 2023-03-07]
3Dparts/STL/ZCarriage/Cutter/CutterOrPenHolder.stl
78.0 x 20.0 x 80.0
