Jurrie/Z99-development/3Dparts/STL/ZCarriage/Dispenser/ST28Holder.stl

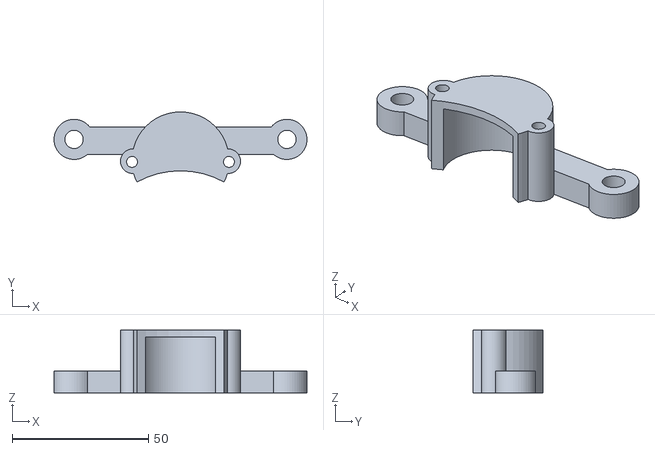
[picture p34: CAD file, 2023-03-07]
3Dparts/STL/ZCarriage/Dispenser/ST28Holder.stl
92.7 x 25.7 x 23.0
