Jurrie/Z99-development/3Dparts/STL/ZCarriage/DrillMill/DCMotor44Holder.stl

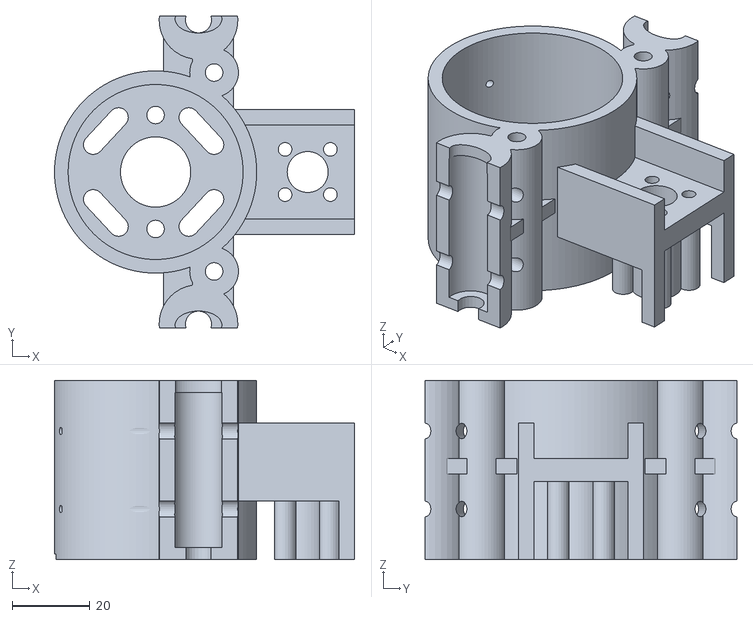
[picture p35: CAD file, 2023-03-07]
3Dparts/STL/ZCarriage/DrillMill/DCMotor44Holder.stl
76.9 x 80.0 x 46.0
