Jurrie/Z99-development/3Dparts/STL/ZCarriage/Laser/ZLaserHolderWithZMotor.stl

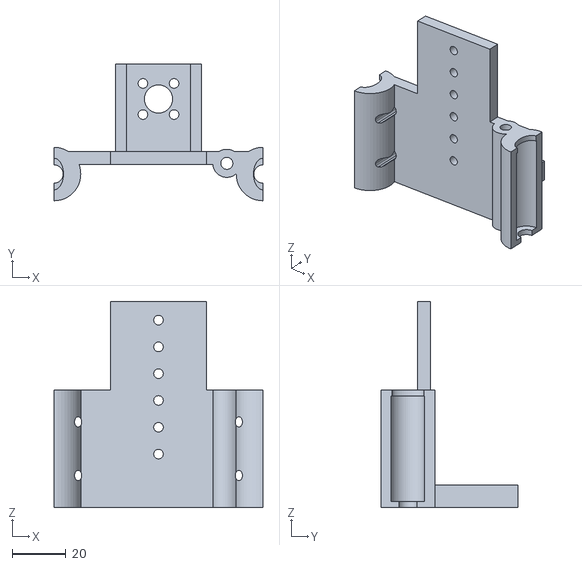
[picture p36: CAD file, 2023-03-07]
3Dparts/STL/ZCarriage/Laser/ZLaserHolderWithZMotor.stl
78.0 x 51.0 x 77.0
