Jurrie/Z99-development/3Dparts/STL/ZCarriage/Plotter/ZPenHolder.stl

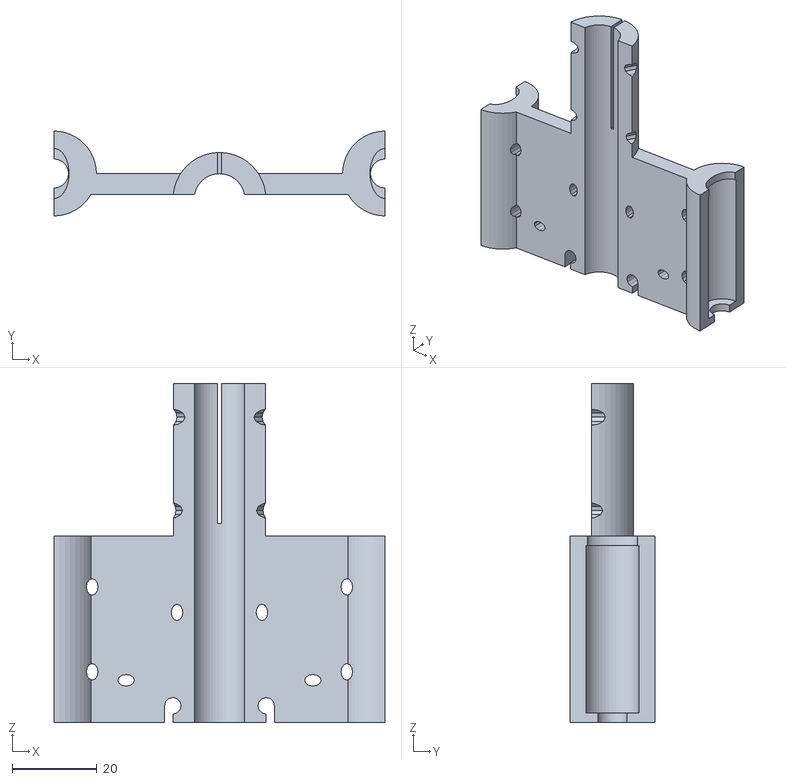
[picture p37: CAD file, 2023-03-07]
3Dparts/STL/ZCarriage/Plotter/ZPenHolder.stl
78.0 x 20.0 x 80.0
