Jurrie/Z99-development/3Dparts/STL/ZCarriage/ZCommonMidPart.stl

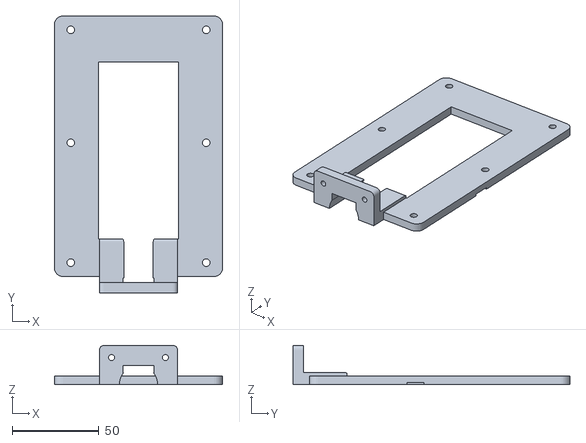
[picture p38: CAD file, 2023-03-07]
3Dparts/STL/ZCarriage/ZCommonMidPart.stl
97.0 x 159.5 x 22.5
