Jurrie/Z99-development/3Dparts/STL/CommonParts/LeftTerminalXDown.stl

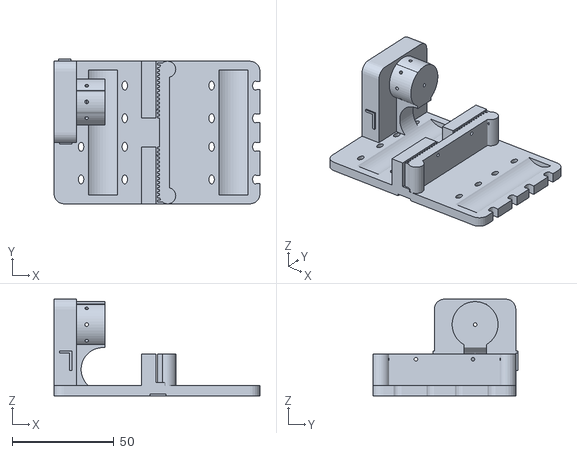
[picture p39: CAD file, 2023-03-07]
3Dparts/STL/CommonParts/LeftTerminalXDown.stl
101.0 x 71.0 x 47.5
