Jurrie/Z99-development/3Dparts/STL/ConstructionAid/Z99XTerminal.stl

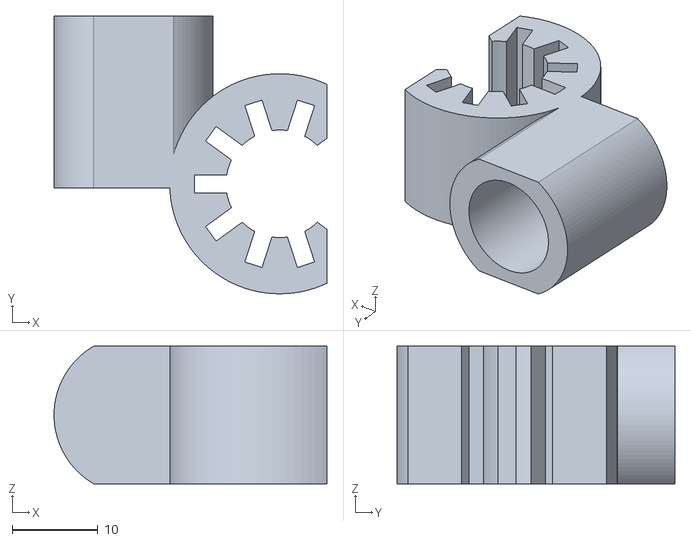
[picture p40: CAD file, 2023-03-07]
3Dparts/STL/ConstructionAid/Z99XTerminal.stl
31.8 x 32.3 x 16.0
