Jurrie/Z99-development/3Dparts/STL/Various/Elevations/Elevation32mm.stl

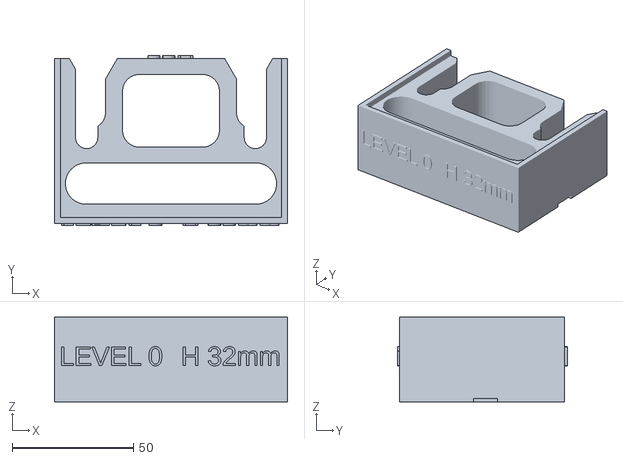
[picture p41: CAD file, 2023-03-07]
3Dparts/STL/Various/Elevations/Elevation32mm.stl
96.0 x 70.0 x 35.0
