Jurrie/Z99-development/3Dparts/STL/Various/LM12LM6Bearings/LM12UU.stl

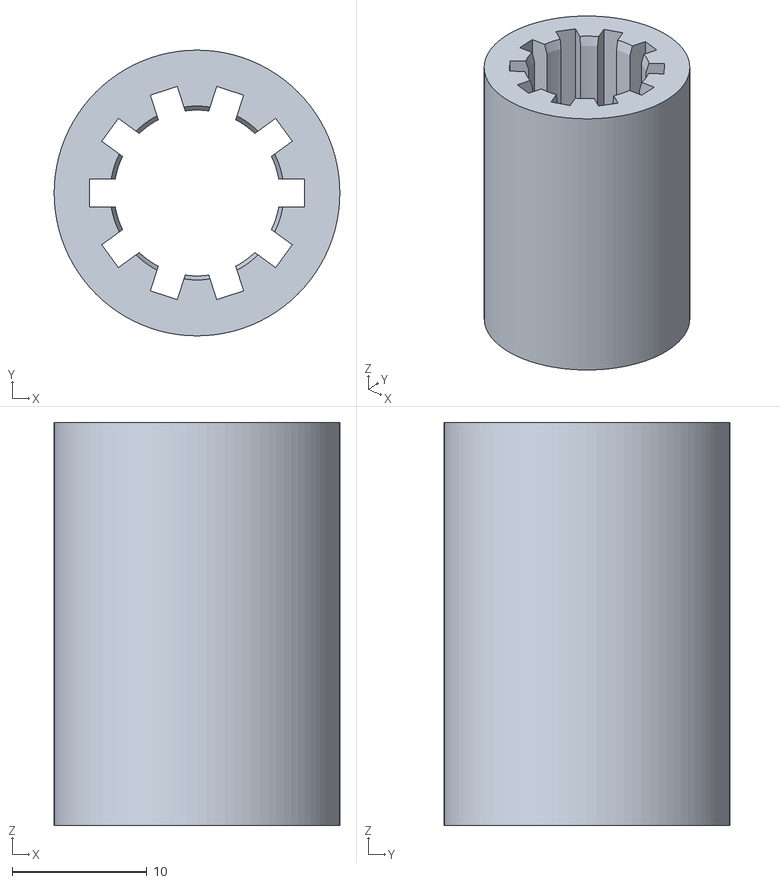
[picture p42: CAD file, 2023-03-07]
3Dparts/STL/Various/LM12LM6Bearings/LM12UU.stl
21.2 x 21.2 x 29.9
