Jurrie/Z99-development/3Dparts/STL/Various/Spacers/SpacerM4L7.stl

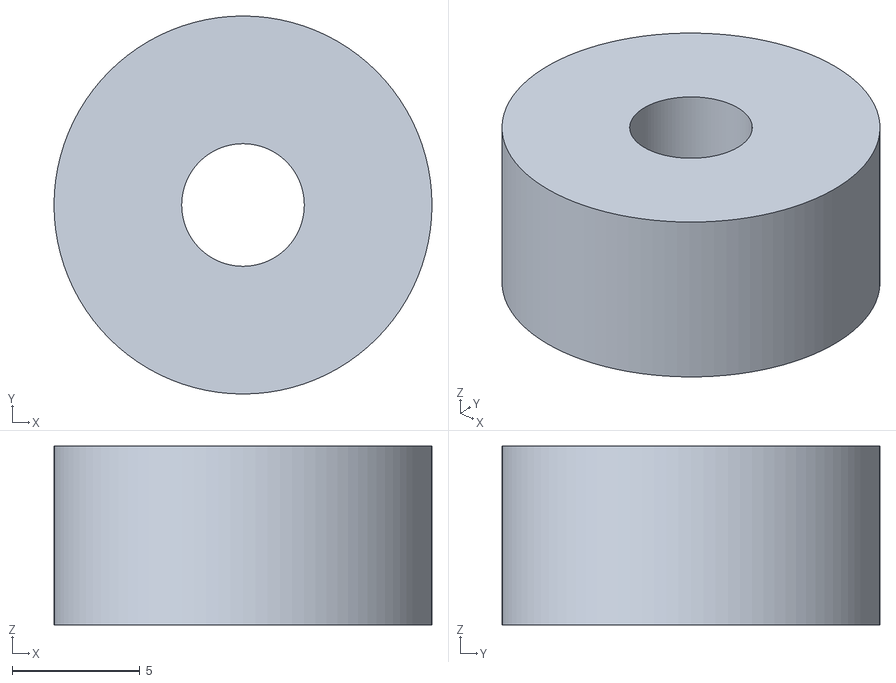
[picture p43: CAD file, 2023-03-07]
3Dparts/STL/Various/Spacers/SpacerM4L7.stl
14.8 x 14.8 x 7.00
