Jurrie/Z99-development/3Dparts/STL/ZCarriage/Cutter/PushCutterOrPen.stl

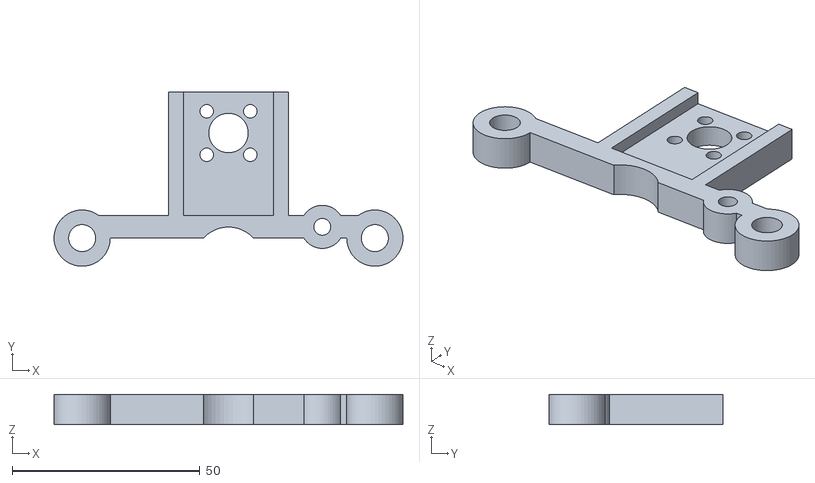
[picture p44: CAD file, 2023-03-07]
3Dparts/STL/ZCarriage/Cutter/PushCutterOrPen.stl
93.0 x 46.5 x 8.00
