Jurrie/Z99-development/3Dparts/STL/ZCarriage/Dispenser/PlungerToM5.stl

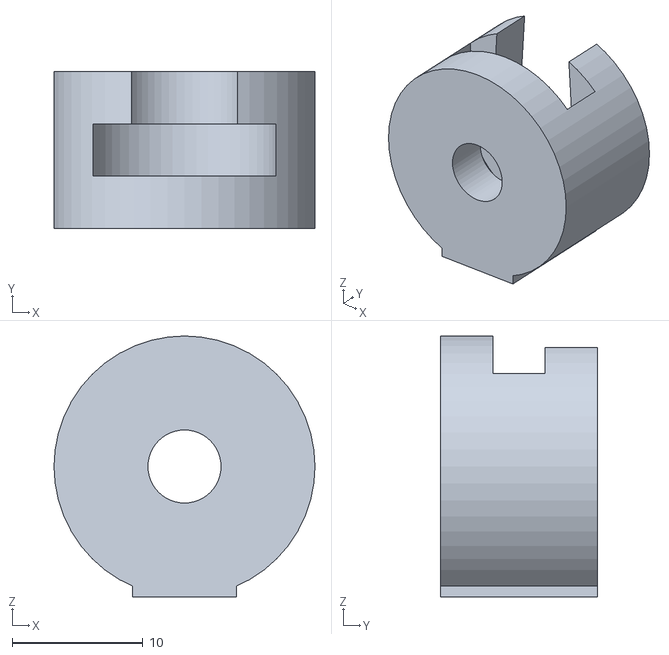
[picture p45: CAD file, 2023-03-07]
3Dparts/STL/ZCarriage/Dispenser/PlungerToM5.stl
20.0 x 12.0 x 20.0
