Jurrie/Z99-development/3Dparts/STL/ZCarriage/DrillMill/DremelHolder.stl

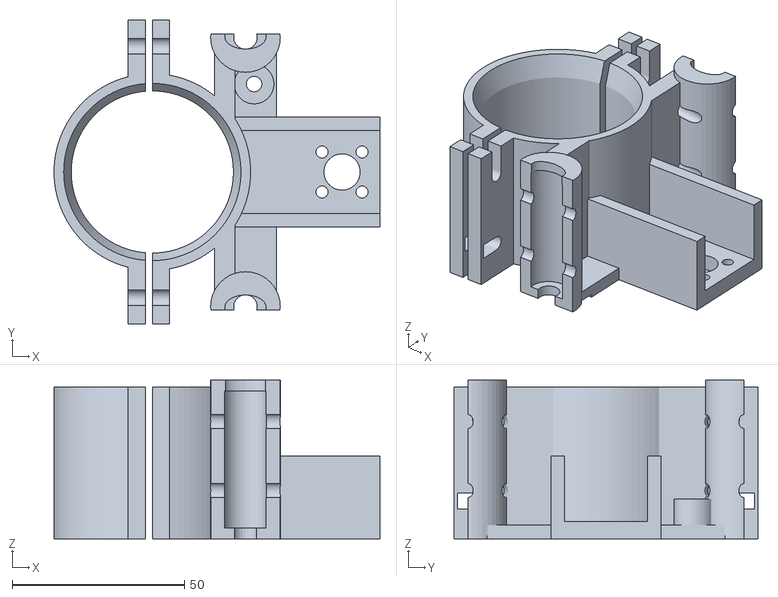
[picture p46: CAD file, 2023-03-07]
3Dparts/STL/ZCarriage/DrillMill/DremelHolder.stl
94.5 x 88.0 x 46.0
