Jurrie/Z99-development/3Dparts/STL/ZCarriage/Laser/ZLaserHolderWithoutZMotor.stl

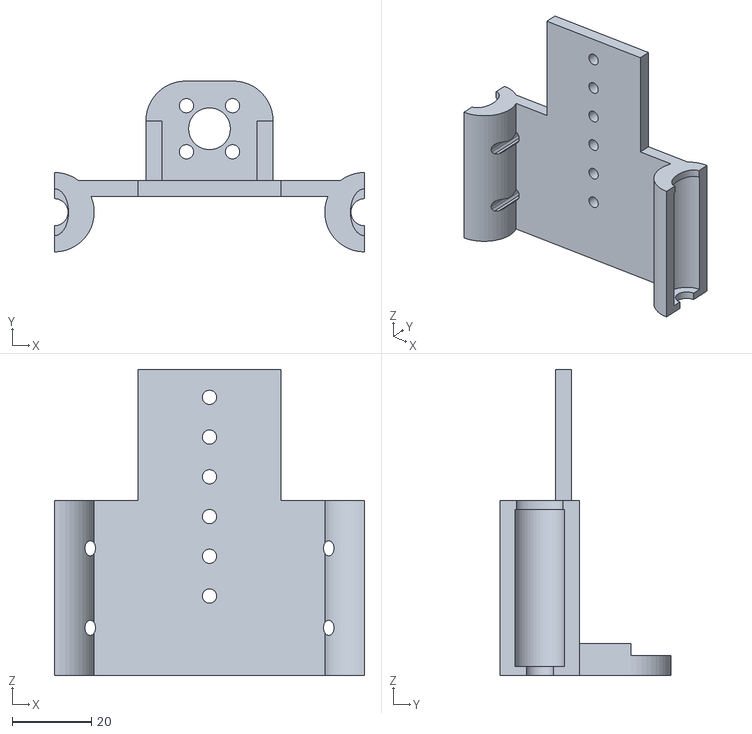
[picture p47: CAD file, 2023-03-07]
3Dparts/STL/ZCarriage/Laser/ZLaserHolderWithoutZMotor.stl
78.0 x 43.0 x 77.0
