Jurrie/Z99-development/3Dparts/STL/ZCarriage/ZCarriageLaserWithoutZMotor.stl

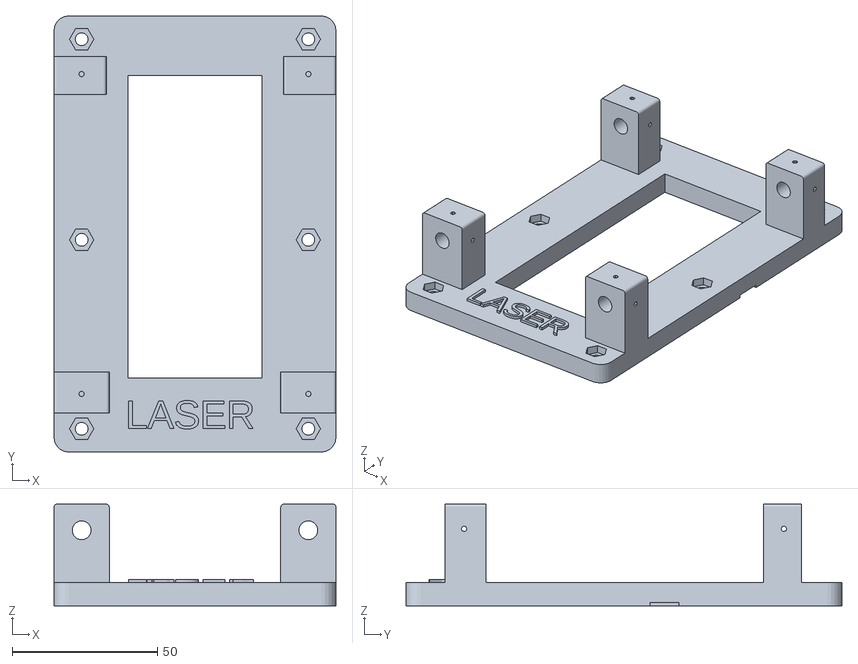
[picture p48: CAD file, 2023-03-07]
3Dparts/STL/ZCarriage/ZCarriageLaserWithoutZMotor.stl
97.0 x 150.0 x 35.0
