Jurrie/Z99-development/3Dparts/STL/Various/Elevations/Elevation36mm.stl

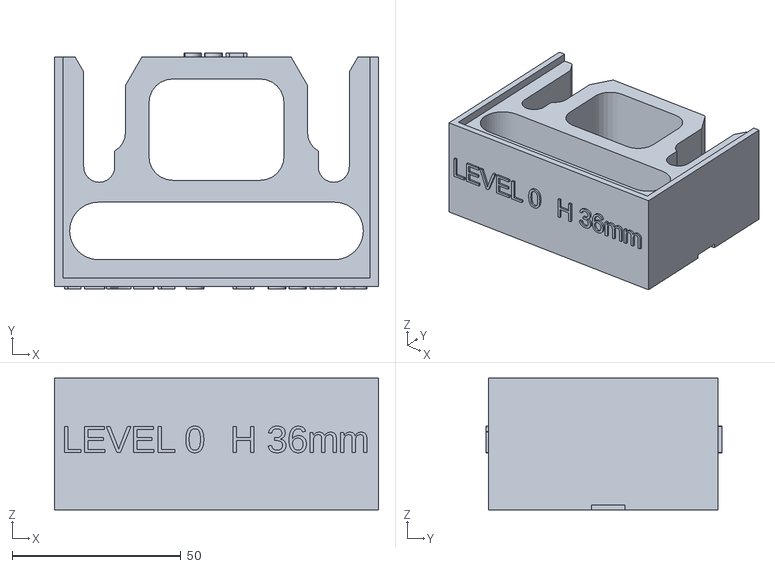
[picture p49: CAD file, 2023-03-07]
3Dparts/STL/Various/Elevations/Elevation36mm.stl
96.0 x 70.0 x 39.0
