Jurrie/Z99-development/3Dparts/STL/Various/Spacers/SpacerM4H3.stl

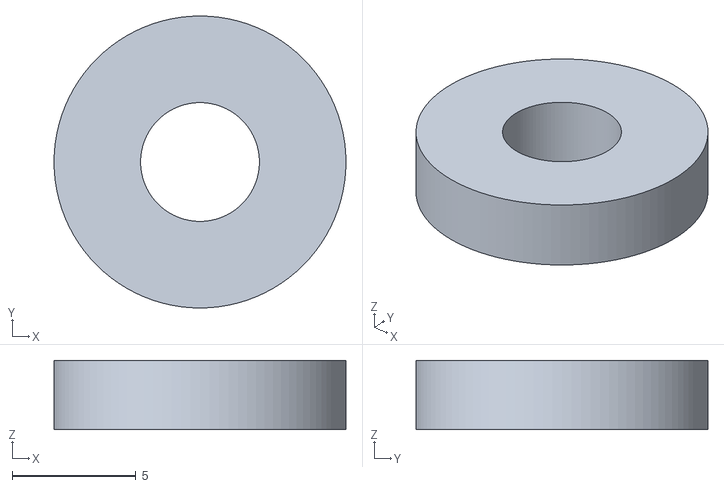
[picture p50: CAD file, 2023-03-07]
3Dparts/STL/Various/Spacers/SpacerM4H3.stl
11.8 x 11.8 x 2.80
