Jurrie/Z99-development/3Dparts/STL/ZCarriage/Dispenser/SyringeHolder2ML.stl

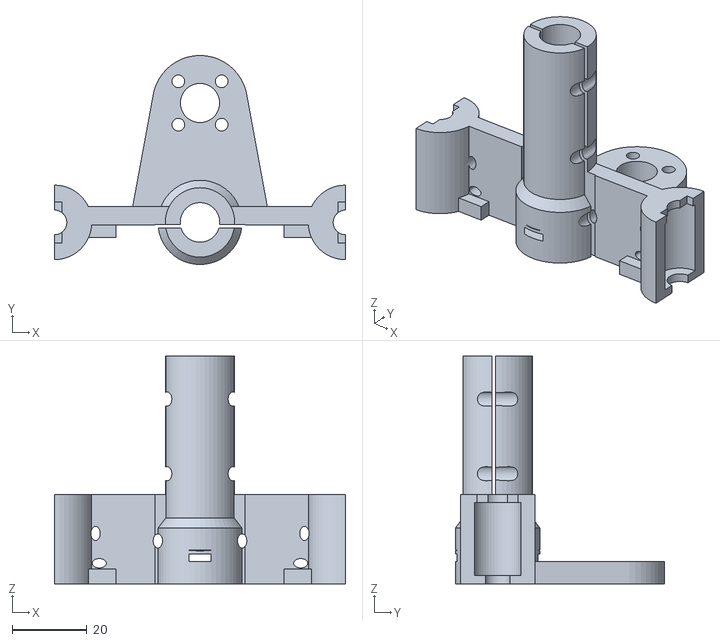
[picture p51: CAD file, 2023-03-07]
3Dparts/STL/ZCarriage/Dispenser/SyringeHolder2ML.stl
78.0 x 56.0 x 61.0
