Jurrie/Z99-development/3Dparts/STL/ZCarriage/DrillMill/SpindleHolder.stl

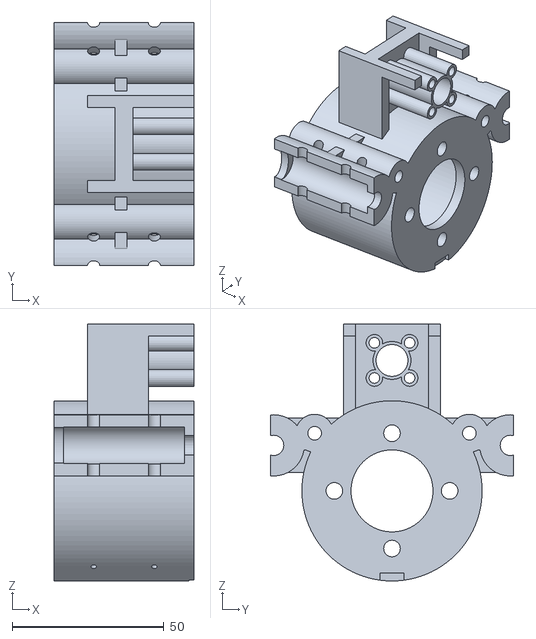
[picture p52: CAD file, 2023-03-07]
3Dparts/STL/ZCarriage/DrillMill/SpindleHolder.stl
46.0 x 80.0 x 84.7
