Jurrie/Z99-development/3Dparts/STL/ZCarriage/ZCarriageDispenserOnlyFrontPart.stl

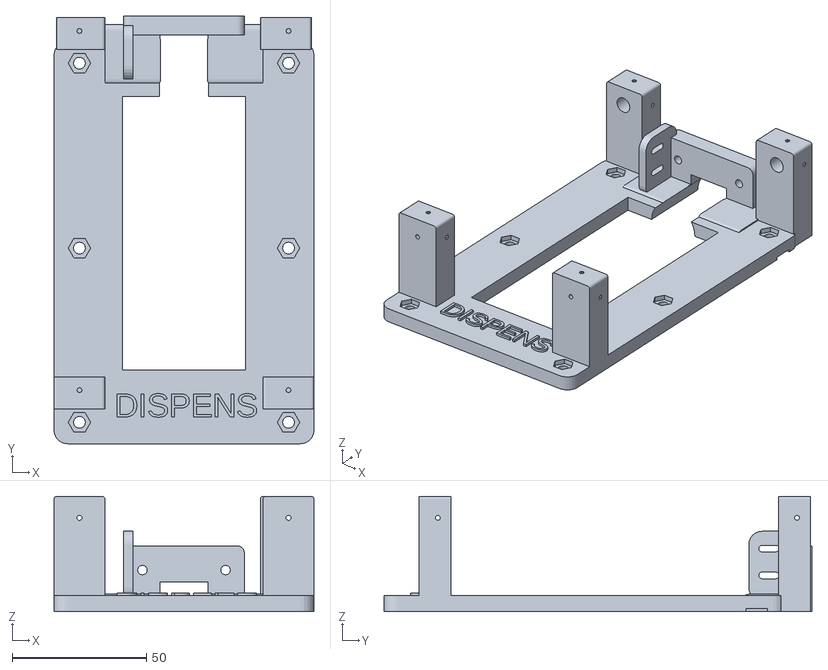
[picture p53: CAD file, 2023-03-07]
3Dparts/STL/ZCarriage/ZCarriageDispenserOnlyFrontPart.stl
97.0 x 159.5 x 43.0
