Jurrie/Z99-development/3Dparts/STL/CommonParts/CornerFrontRightBackLeft.stl

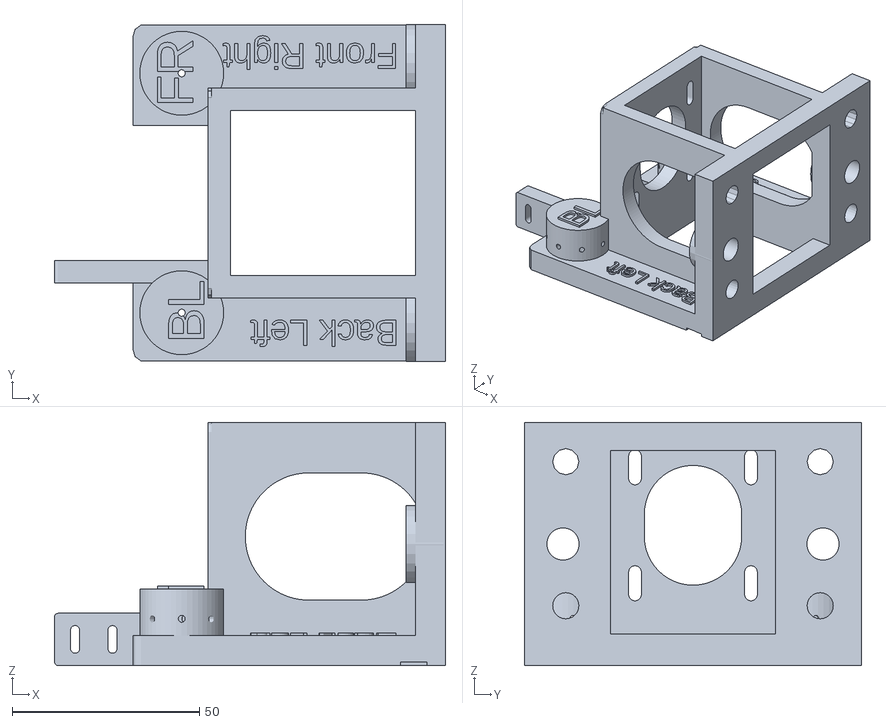
[picture p54: CAD file, 2023-03-07]
3Dparts/STL/CommonParts/CornerFrontRightBackLeft.stl
104.5 x 90.1 x 65.0
