Jurrie/Z99-development/3Dparts/STL/Various/Spacers/SpacerM4L14Backside.stl

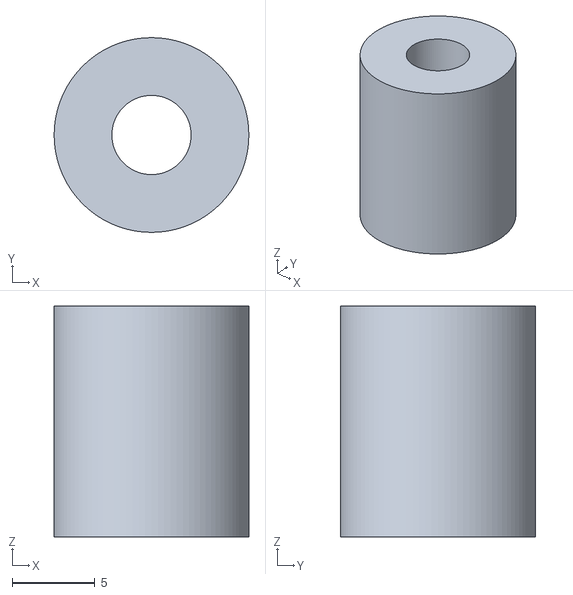
[picture p55: CAD file, 2023-03-07]
3Dparts/STL/Various/Spacers/SpacerM4L14Backside.stl
11.8 x 11.8 x 14.0
