Jurrie/Z99-development/3Dparts/STL/ZCarriage/Dispenser/DispHexNutM5Holder.stl

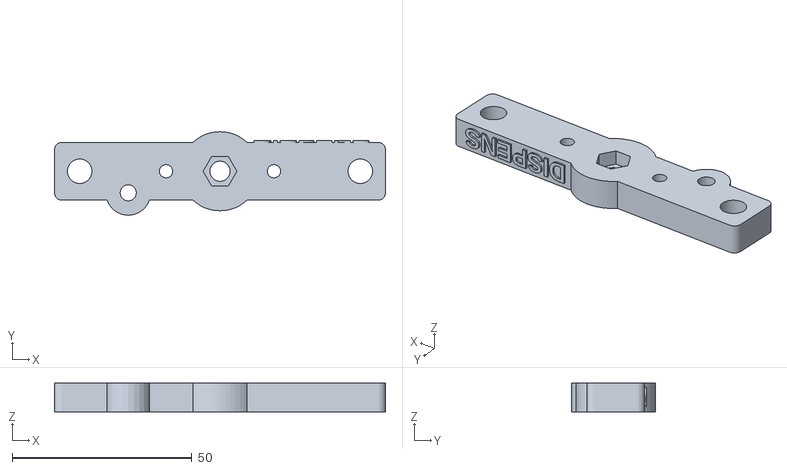
[picture p56: CAD file, 2023-03-07]
3Dparts/STL/ZCarriage/Dispenser/DispHexNutM5Holder.stl
92.0 x 23.2 x 8.00
