Jurrie/Z99-development/3Dparts/STL/ZCarriage/DrillMill/FixPCB.stl

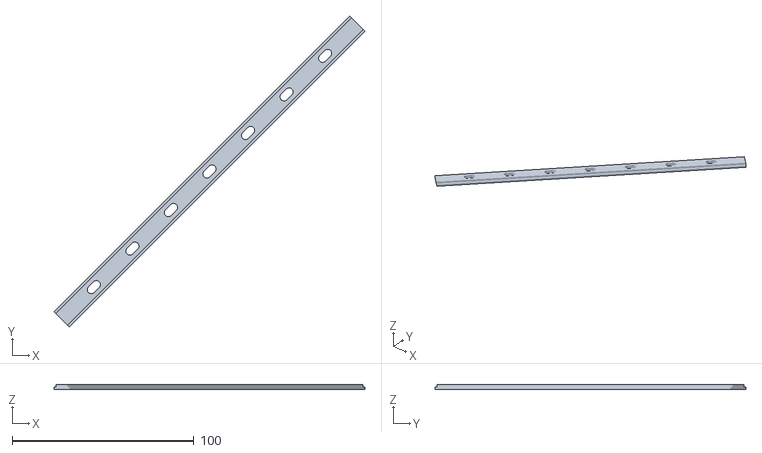
[picture p57: CAD file, 2023-03-07]
3Dparts/STL/ZCarriage/DrillMill/FixPCB.stl
171.1 x 171.1 x 3.00
