Jurrie/Z99-development/3Dparts/STL/ZCarriage/ZCommonFrontPart.stl

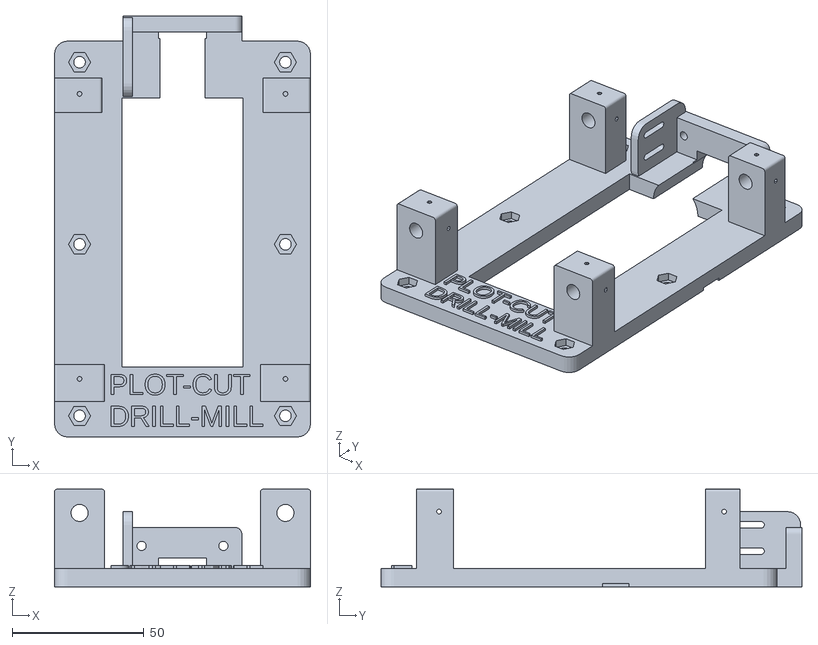
[picture p58: CAD file, 2023-03-07]
3Dparts/STL/ZCarriage/ZCommonFrontPart.stl
97.0 x 159.5 x 37.0
