Jurrie/Z99-development/3Dparts/STL/CommonParts/BoxACRelais.stl

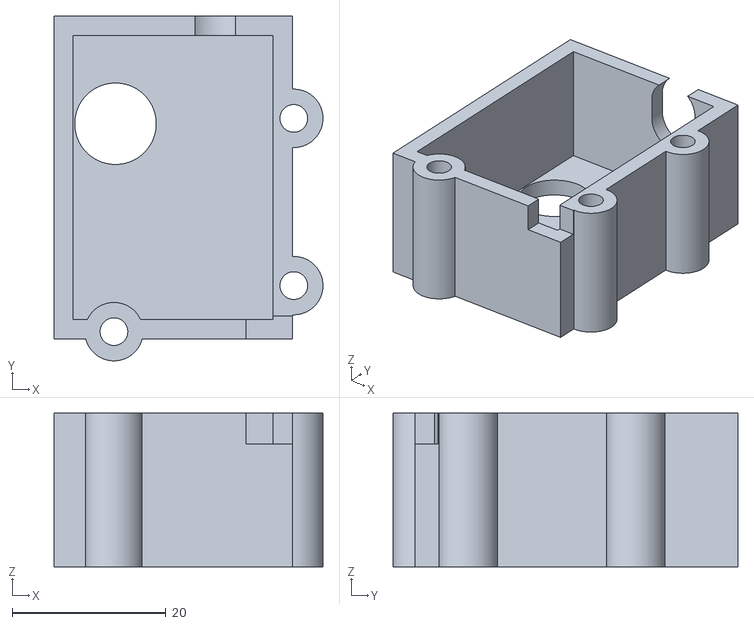
[picture p59: CAD file, 2023-03-07]
3Dparts/STL/CommonParts/BoxACRelais.stl
35.0 x 44.9 x 20.0
