Jurrie/Z99-development/3Dparts/STL/ZCarriage/CollarM6.stl

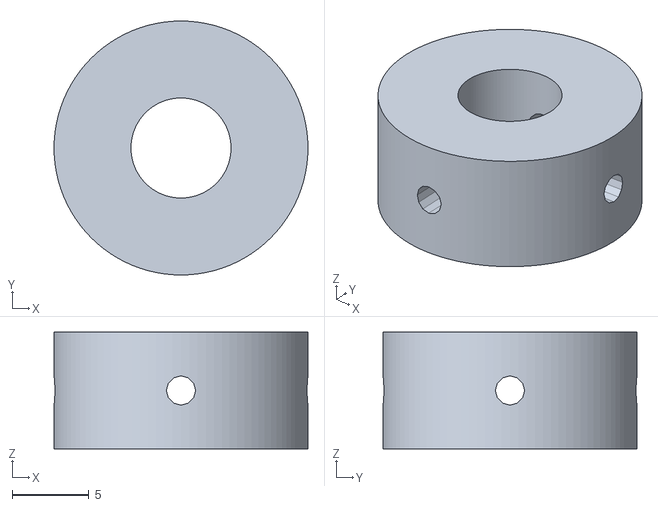
[picture p60: CAD file, 2023-03-07]
3Dparts/STL/ZCarriage/CollarM6.stl
16.5 x 16.5 x 7.60
