Jurrie/Z99-development/3Dparts/STL/ZCarriage/Dispenser/DispMiddlePart.stl

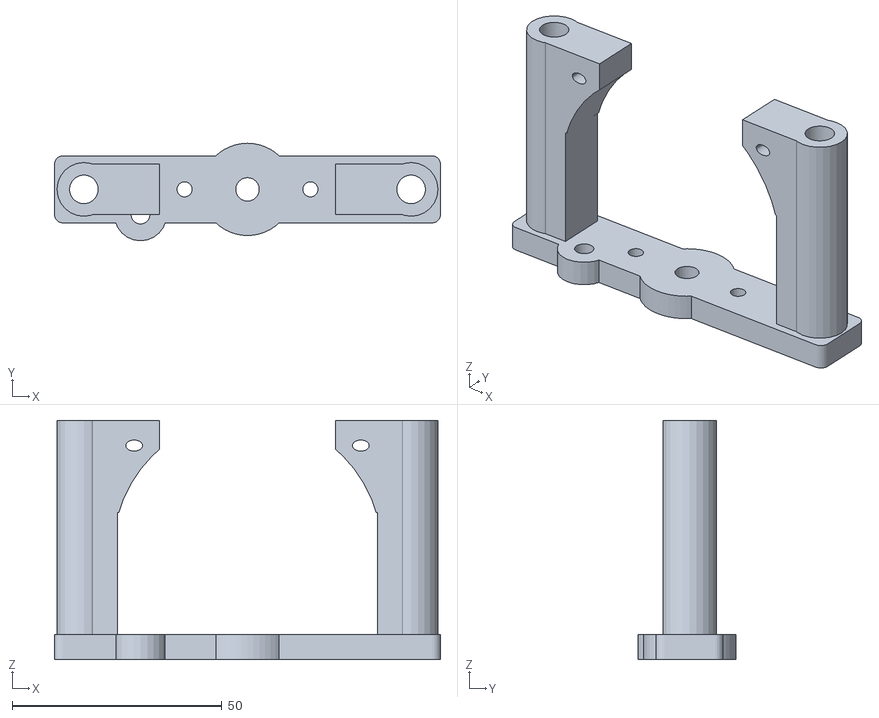
[picture p61: CAD file, 2023-03-07]
3Dparts/STL/ZCarriage/Dispenser/DispMiddlePart.stl
92.0 x 23.2 x 57.0
