Jurrie/Z99-development/3Dparts/STL/ZCarriage/DrillMill/AdapterVacuumCleaner.stl

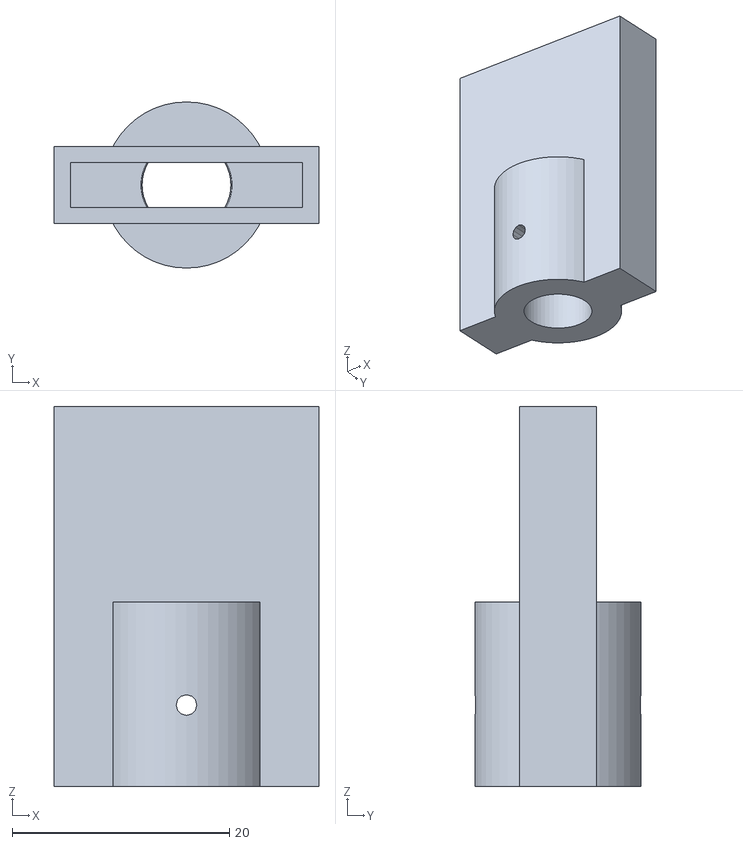
[picture p62: CAD file, 2023-03-07]
3Dparts/STL/ZCarriage/DrillMill/AdapterVacuumCleaner.stl
24.4 x 15.3 x 35.0
