Jurrie/Z99-development/3Dparts/STL/CommonParts/FixX2Y4ZRPCB.stl

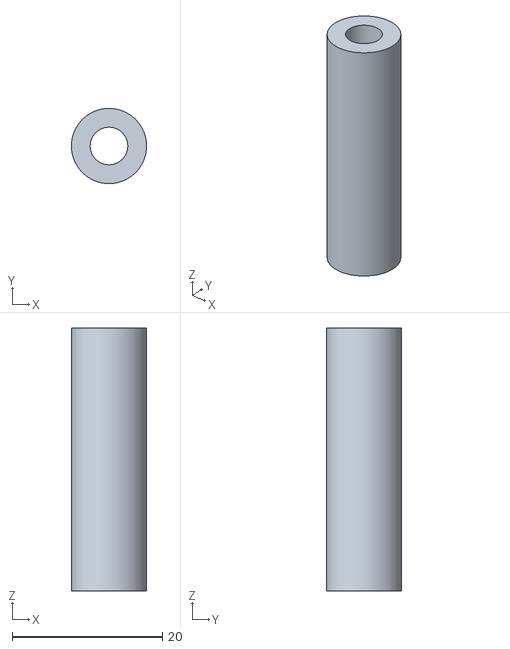
[picture p63: CAD file, 2023-03-07]
3Dparts/STL/CommonParts/FixX2Y4ZRPCB.stl
10.0 x 10.0 x 35.0
