Jurrie/Z99-development/3Dparts/STL/ZCarriage/DrillMill/DCMotor37Holder.stl

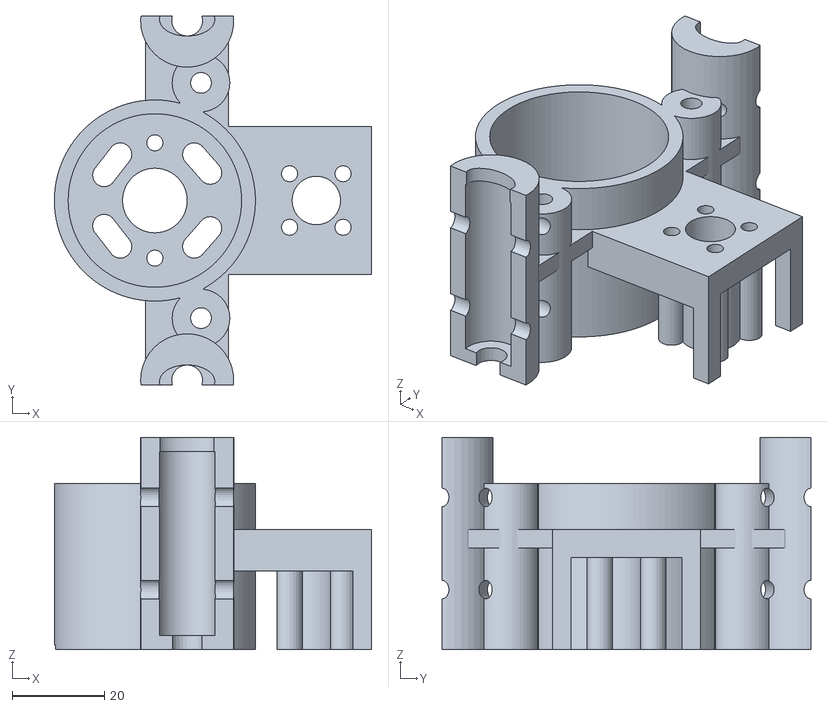
[picture p64: CAD file, 2023-03-07]
3Dparts/STL/ZCarriage/DrillMill/DCMotor37Holder.stl
68.8 x 80.0 x 46.0
