Jurrie/Z99-development/3Dparts/STL/ZCarriage/ZCommonBackPart.stl

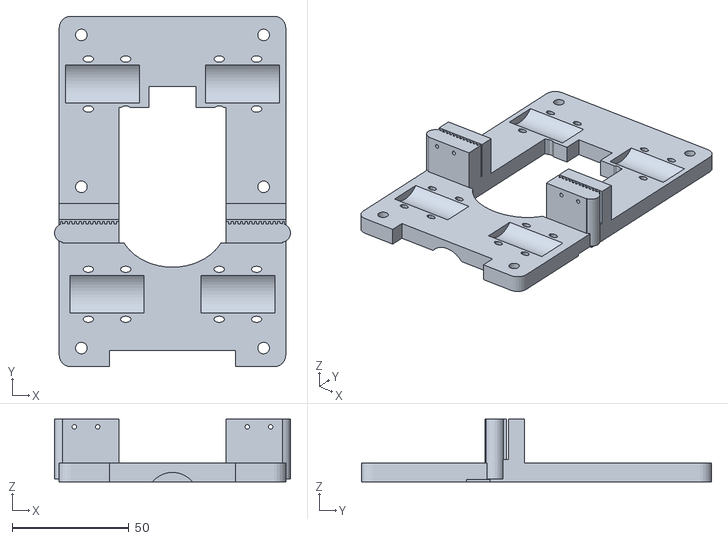
[picture p65: CAD file, 2023-03-07]
3Dparts/STL/ZCarriage/ZCommonBackPart.stl
101.0 x 150.0 x 26.8
