Jurrie/Z99-development/3Dparts/STL/CommonParts/LargeFanCornerFix.stl

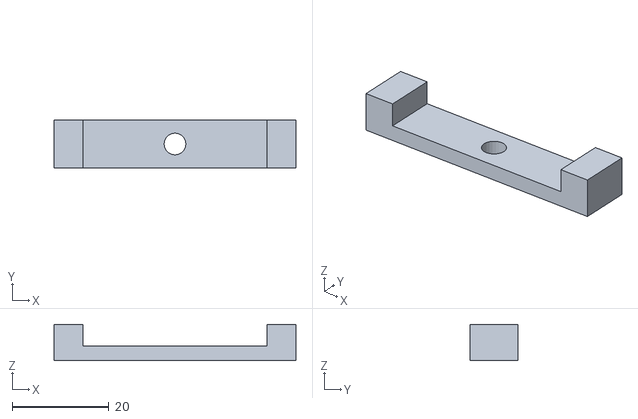
[picture p66: CAD file, 2023-03-07]
3Dparts/STL/CommonParts/LargeFanCornerFix.stl
50.0 x 10.0 x 7.50
