Jurrie/Z99-development/3Dparts/STL/ZCarriage/DrillMill/SuctionHolder.stl

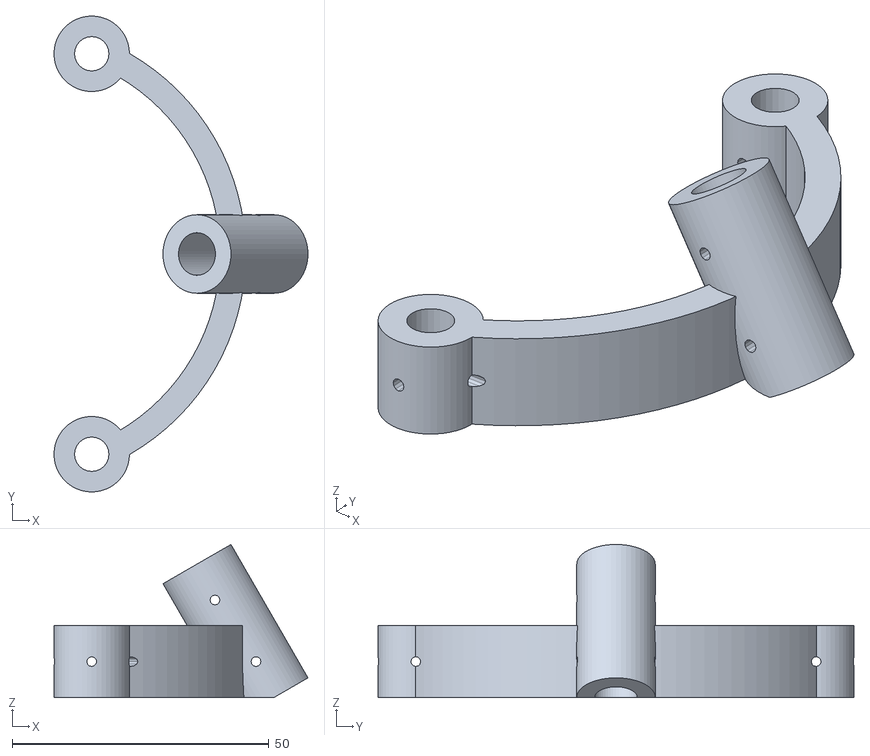
[picture p67: CAD file, 2023-03-07]
3Dparts/STL/ZCarriage/DrillMill/SuctionHolder.stl
49.5 x 92.7 x 29.8
