Jurrie/Z99-development/3Dparts/ScadSourceCode/ZCarriage/Laser/ZLaserHolderWithoutZMotor.scad

// Laser holder for manual Z height adjustment
// Don't forget to add jumper for Z switch on X2Y4ZR PCB, see manual

   DiaM3=3.6;    // fix trapezoideal screw and laser with M3
   DiaM4 = 4.5;  // Z switch activation
   DiaM6=6.8;    // M6 shaft 
   DiaTie=3.9;    // fix LM6UU holders  
   Height=74;      
   LM6Height = 24;  


   color("lime")          
         
 rotate([180,0,0])  //180: no need to rotate in Slic3r        
   {        
difference()
{ 
  union()
  {                    
                        
   // side LM6UU dual holder     
          translate([39,0,-10])
       cylinder(h=LM6Height+20 ,d=20 ,center=true,$fn=48);  //
            
          translate([-39,0,-10])
       cylinder(h=LM6Height+20 ,d=20 ,center=true,$fn=48);  //
                
 // connect central  part:   
        translate([0,-6,-10])
      cube([76,4,LM6Height+20],center=true);   
      
         // backplate for laser
      
     translate([0,-6,-27.0])  // -1.5  
       cube([36,4 ,76 ] ,center=true);  //38

      
      
  // Fix trapezoideal screw 
     minkowski()
     {
        translate([0,-18.5,9.5])                  
      cube([12,9,4],center=true);    
      
         cylinder(h=1,d=20,$fn=48,center =true);
     }  
     //  reinforcement
           
 translate([14.0,-13.5,8])   
      cube([4.0,19,8]  ,center=true);           
            
 translate([-14.0,-13.5,8])          
      cube([4.0,19,8]  ,center=true);   
                             
  }    
            // END UNION
     
    
  // OPENING NUT TRAPEZOIDEAL SCREW
    
     translate([0,-21,10])    
      cylinder(h=20,d=10.5,center=true,$fn=48); 
    
    // FIX NUT OF TRAPEZOIDAL SCREW     
    translate([5.8,-21+5.8,10])   
      cylinder(h=20,d=DiaM3,center=true,$fn=24);      
                
    translate([5.8,-21-5.8,10])   
      cylinder(h=20,d=DiaM3,center=true,$fn=24); 
    
     translate([-5.8,-21+5.8,10])    
      cylinder(h=20,d=DiaM3,center=true,$fn=24);      
                
    translate([-5.8,-21-5.8,10]) 
      cylinder(h=20,d=DiaM3,center=true,$fn=24);  
 
 //  LM6 holders 
      translate([-39,0,-10])
       cylinder(h=19.5+20 ,d=12.5 ,center=true,$fn=48); 
           
  //  LM6 holder 
      translate([39,0,-10])
       cylinder(h=19.5 +20,d=12.5 ,center=true,$fn=48); 
    
 // left shaft  
      translate([39,0,-10])
       cylinder(h=25+20 ,d=DiaM6 ,center=true,$fn=48); 
         
 // right shaft
 
      translate([-39,0,-10])
       cylinder(h=25+20 ,d=DiaM6 ,center=true,$fn=48); 
       
      // upwards more room for LM6UU shafts:   
 // left shaft  
      translate([39,0,-30])
      scale([0.6,1,1])
       cylinder(h=25 ,d=DiaM6+5 ,center=true,$fn=48);  
    
  // left shaft  
      translate([-39,0,-30])
      scale([0.6,1,1])
       cylinder(h=25 ,d=DiaM6+5 ,center=true,$fn=48); 

//  fix LM6 with ties 
        
  translate([30.0,0,0])    
  rotate([90,0,0]) 
  scale([0.7,1,1])
  cylinder(h=20 ,d=DiaTie,center=true,$fn=12); 
        
  translate([-30,0,0])    
  rotate([90,0,0]) 
   scale([0.7,1,1])
  cylinder(h=20 ,d=DiaTie,center=true,$fn=12);  
     
     
//  fix LM6 with ties  
        
  translate([30.0,0,-20])    
  rotate([90,0,0]) 
  scale([0.7,1,1])
  cylinder(h=20 ,d=DiaTie,center=true,$fn=12);  
        
  translate([-30,0,-20])   
  rotate([90,0,0]) 
   scale([0.7,1,1])
  cylinder(h=20 ,d=DiaTie,center=true,$fn=12); 
     
    // lateral removal :
 translate([49,0,-10])
  cube([20,30,30+20],center=true);
  
     translate([-49,0,-10])
  cube([20,30,30+20],center=true);
    
   // Fix the laser with M3    
                                 
     for (x=[0:1:5])
      translate([0,0,-58+x*10])
        rotate([90,0,0])     
      cylinder(h=24,d=DiaM3, center=true,$fn=24);
    
    }
 }  // end rotate
         
         
