Jurrie/Z99-development/3Dparts/ScadSourceCode/ZCarriage/Dispenser/DistanceH12.scad

difference()
{
cylinder(h=12,d=5.6+5.6,center=true,$fn=48);
cylinder(h=14,d=5.6,center=true,$fn=48);
}
