Jurrie/Z99-development/3Dparts/ScadSourceCode/ZCarriage/Dispenser/DistanceH6.scad

difference()
{
cylinder(h=6,d=5.6+5,center=true,$fn=48);
cylinder(h=8,d=5.6,center=true,$fn=48);
}
