Jurrie/Z99-development/(list of files, cad)

Other CAD files:
3Dparts/STL/CommonParts/LeftTerminalXUp.stl
3Dparts/STL/CommonParts/RightTerminalXDown.stl
3Dparts/STL/CommonParts/CornerFrontLeftBackRight.stl
3Dparts/ScadSourceCode/ZCarriage/DrillMill/DCMotor37Holder.scad
3Dparts/ScadSourceCode/ZCarriage/DrillMill/DCMotor44Holder.scad
3Dparts/ScadSourceCode/ZCarriage/Laser/ZLaserHolderWithZMotor.scad
3Dparts/ScadSourceCode/CommonParts/CornerFrontRightBackLeft.scad
3Dparts/ScadSourceCode/CommonParts/RightTerminalX.scad
3Dparts/ScadSourceCode/ZCarriage/ZCommonCarriagePlotCutDrillMillLaser.scad
3Dparts/ScadSourceCode/Various/Elevations/Elevation32mm.scad
3Dparts/ScadSourceCode/Various/Elevations/Elevation36mm.scad
3Dparts/ScadSourceCode/Various/Elevations/LEVELmin2H40.scad
3Dparts/ScadSourceCode/Various/Elevations/LEVELzeroH10.scad
3Dparts/ScadSourceCode/Various/Elevations/LEVELzeroH40.scad
3Dparts/ScadSourceCode/Various/Elevations/LEVELzeroH60.scad
3Dparts/ScadSourceCode/Various/MakeSpring/MakeSpring8mm.scad
3Dparts/ScadSourceCode/Various/Spacers/SpacerM4L7.scad
3Dparts/ScadSourceCode/Various/Spacers/SpacerM8L30.scad
3Dparts/ScadSourceCode/Various/Spacers/SpacerM8L40.scad
3Dparts/ScadSourceCode/ZCarriage/Plotter/PushCutterOrPen.scad
3Dparts/ScadSourceCode/ZCarriage/Plotter/ZPenHolder.scad
3Dparts/ScadSourceCode/ZCarriage/Plotter/OldZPenHolder.scad
