Jurrie/Z99-development/(list of files, drawings)

Other design files:
PCB_LayoutAndSchematicDesign/DesignsparkPCB/X2Y4Z.pcb
