Jurrie/Z99-development/PCB_LayoutAndSchematicDesign/KiCadSchematic/X2Y4Z.kicad_sch

## KiCad design PCB_LayoutAndSchematicDesign/KiCadSchematic/X2Y4Z.kicad_sch (2023-03-07)

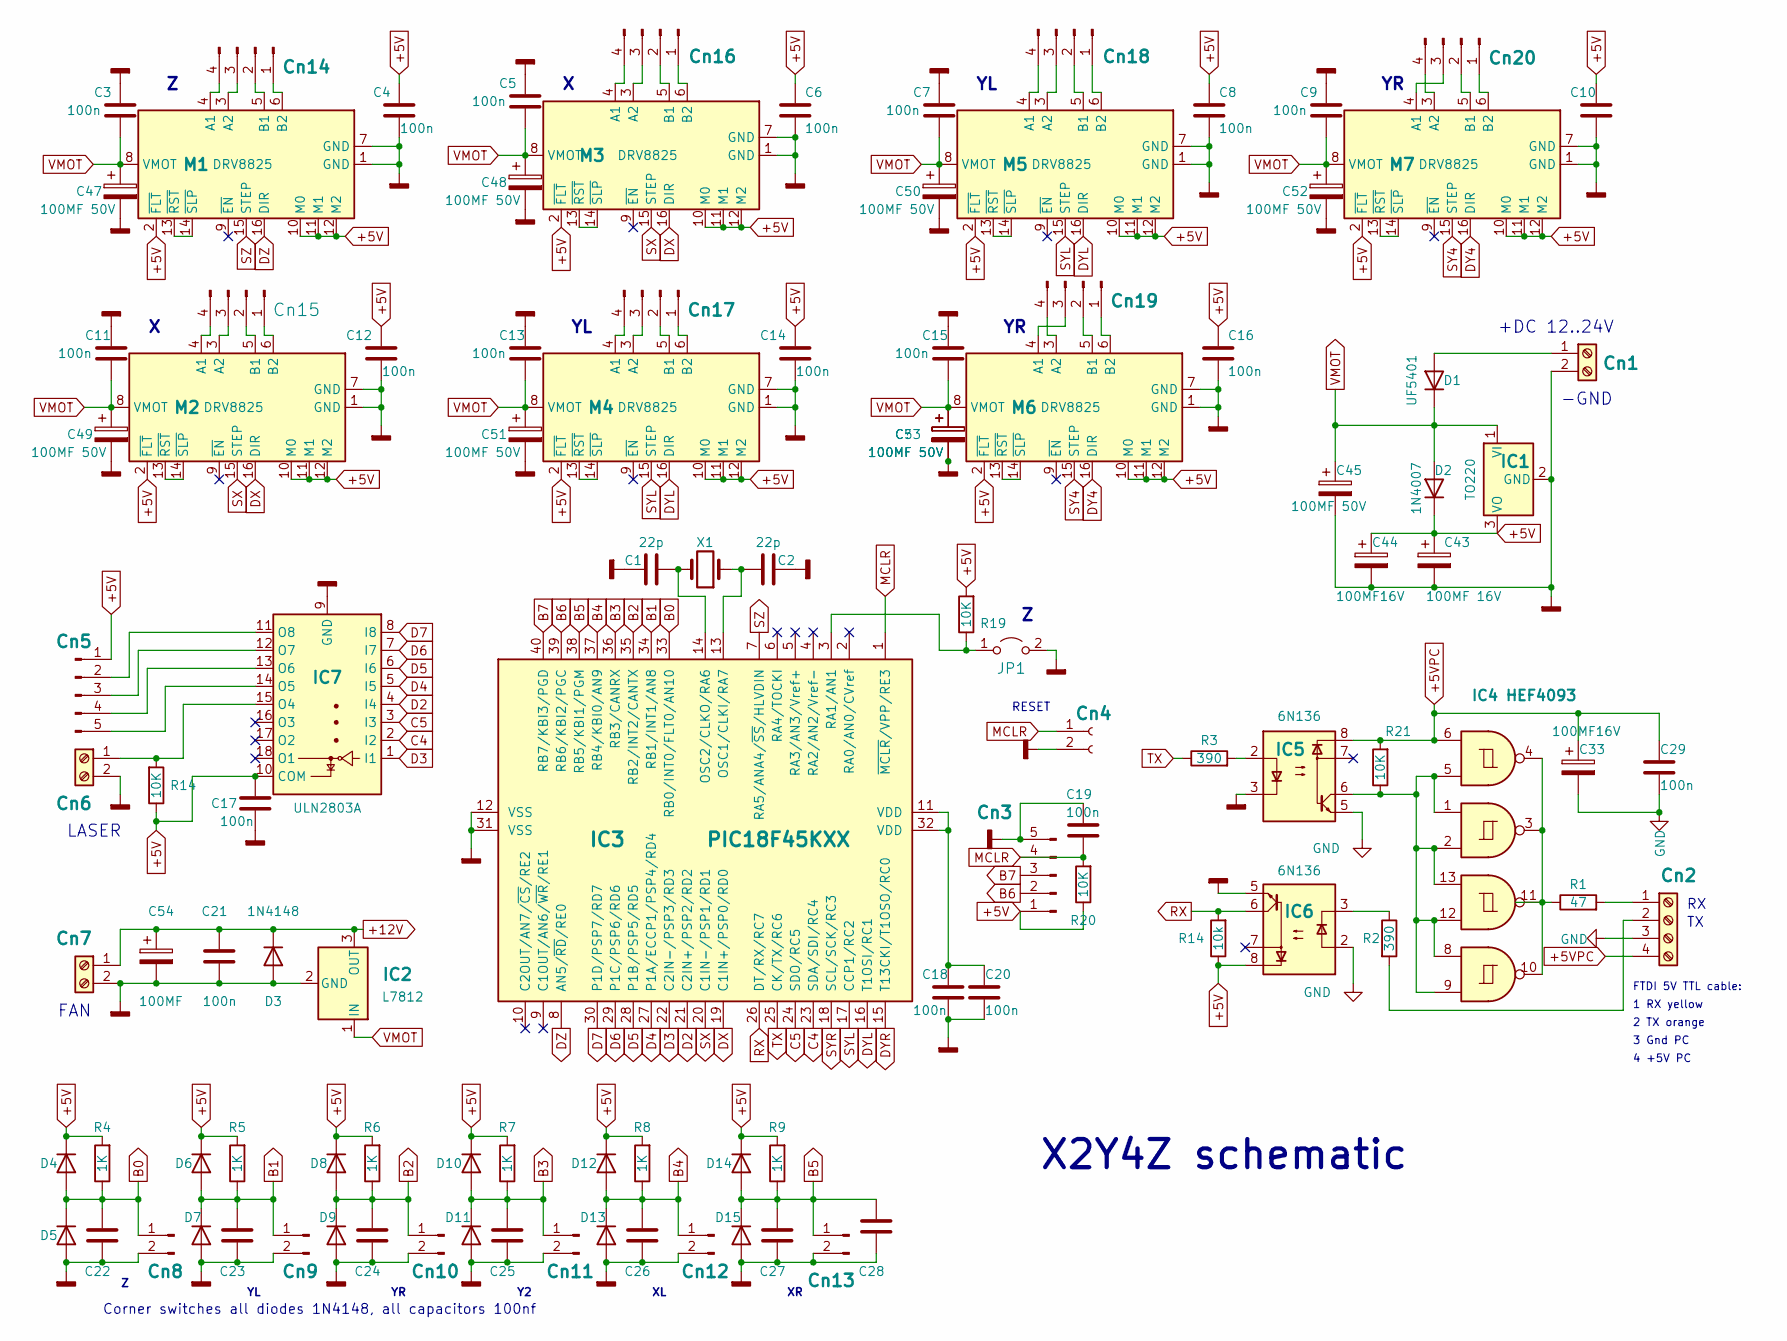
[picture p68: schematic X2Y4Z.kicad_sch]

Parts:
C1, C2: 22p; C_0805
C3, C4, C5, C6, C7, C8, C9, C10, C11, C12, C13, C14, C15, C16, C17, C18, C19, C20, C21, C29: 100n; C_0805
C28: C27; C_0805
C33, C44: 100MF16V; CP_Radial_D12.5mm_P2.50mm
C43: 100MF 16V; CP_Radial_D12.5mm_P2.50mm
C45, C47, C48, C49, C50, C51, C52, C53: 100MF 50V; CP_Radial_D12.5mm_P2.50mm
C54: 100MF; CP_Radial_D12.5mm_P2.50mm
Cn1, Cn6, Cn7: Screw_Terminal_01x02
Cn2: Screw_Terminal_01x04
Cn3, Cn5: Conn_01x05_Male; Molex_KK-6410-05_05x2.54mm_Straight
Cn4: Conn_01x02_Female
Cn8, Cn9, Cn10, Cn11, Cn12, Cn13: ConnZ
Cn14, Cn15, Cn16, Cn17, Cn18, Cn19, Cn20: Conn_01x04_Male
D1: UF5401; D_DO-41_SOD81_P10.16mm_Horizontal
D2: 1N4007; D_DO-41_SOD81_P10.16mm_Horizontal
D3: 1N4148; D_DO-41_SOD81_P10.16mm_Horizontal
D4, D5, D6, D7, D8, D9, D10, D11, D12, D13, D14, D15: 1N4148; D_DO-35_SOD27_P7.62mm_Horizontal
IC1: TO220; TO-220-3_Vertical
IC2: L7812
IC3: PIC18F45KXX; DIP-40_W15.24mm
IC5, IC6: 6N136; DIP-8_W7.62mm
IC7: ULN2803A; SO-18-ULN2803
JP1: Jumper_2_Open
M1, M2, M3, M4, M5, M6, M7: DRV8825; Pololu_Breakout-16_15.2x20.3mm
R1: 47; R_0805
R2, R3: 390; R_0805
R4, R5, R6, R7, R8, R9: 1K; R_0805
R14: 10k; R_0805
R19, R20, R21: 10K; R_0805
U4: HEF4093B
X1: 14.xxMHZ; Crystal_HC49-U_Vertical

Connections:
+5V: C4.1, C6.1, C8.1, C10.1, C12.1, C14.1, C16.1, C17.1, C43.1, C44.1, Cn3.1, Cn5.1, D2.1 (K), D4.1 (K), D6.1 (K), D8.1 (K), D10.1 (K), D12.1 (K), D14.1 (K), IC1.3 (VO), IC6.8, IC7.10 (COM), M1.2 (~FLT), M1.10 (M0), M1.11 (M1), M1.12 (M2), M2.2 (~FLT), M2.10 (M0), M2.11 (M1), M2.12 (M2), M3.2 (~FLT), M3.10 (M0), M3.11 (M1), M3.12 (M2), M4.2 (~FLT), M4.10 (M0), M4.11 (M1), M4.12 (M2), M5.2 (~FLT), M5.10 (M0), M5.11 (M1), M5.12 (M2), M6.2 (~FLT), M6.10 (M0), M6.11 (M1), M6.12 (M2), M7.2 (~FLT), M7.10 (M0), M7.11 (M1), M7.12 (M2), R4.2, R5.2, R6.2, R7.2, R8.2, R9.2, R14.1, R19.2, R20.1
+5VPC: C29.2, C33.1, Cn2.4, IC5.8, R21.2
+12V: C21.2, C54.1, Cn7.1, D3.1 (K), IC2.3 (OUT)
B0: Cn8.1, D4.2 (A), D5.1 (K), IC3.33 (RB0/INT0/FLT0/AN10), R4.1
B1: Cn9.1, D6.2 (A), D7.1 (K), IC3.34 (RB1/INT1/AN8), R5.1
B2: Cn10.1, D8.2 (A), D9.1 (K), IC3.35 (RB2/INT2/CANTX), R6.1
B3: Cn11.1, D10.2 (A), D11.1 (K), IC3.36 (RB3/CANRX), R7.1
B4: Cn12.1, D12.2 (A), D13.1 (K), IC3.37 (RB4/KBI0/AN9), R8.1
B5: C28.2, Cn13.1, D14.2 (A), D15.1 (K), IC3.38 (RB5/KBI1/PGM), R9.1
B6: Cn3.2, IC3.39 (RB6/KBI2/PGC)
B7: Cn3.3, IC3.40 (RB7/KBI3/PGD)
C4: IC3.23 (SDA/SDI/RC4), IC7.2 (I2)
C5: IC3.24 (SDO/RC5), IC7.3 (I3)
D2: IC3.21 (C2IN+/PSP2/RD2), IC7.4 (I4)
D3: IC3.22 (C2IN-/PSP3/RD3), IC7.1 (I1)
D4: IC3.27 (P1A/ECCP1/PSP4/RD4), IC7.5 (I5)
D5: IC3.28 (P1B/PSP5/RD5), IC7.6 (I6)
D6: IC3.29 (P1C/PSP6/RD6), IC7.7 (I7)
D7: IC3.30 (P1D/PSP7/RD7), IC7.8 (I8)
DX: IC3.19 (C1IN+/PSP0/RD0), M2.16 (DIR), M3.16 (DIR)
DY4: M6.16 (DIR), M7.16 (DIR)
DYL: IC3.16 (T1OSI/RC1), M4.16 (DIR), M5.16 (DIR)
DYR: IC3.15 (T13CKI/T1OSO/RC0)
DZ: IC3.8 (AN5/~RD/RE0), M1.16 (DIR)
MCLR: C19.2, Cn3.4, Cn4.1, IC3.1 (~MCLR/VPP/RE3), R20.2
unnamed: C1.2, IC3.14 (OSC2/CLKO/RA6), X1.2
unnamed: C2.1, IC3.13 (OSC1/CLKI/RA7), X1.1
unnamed: C4.2, M1.1 (GND), M1.7 (GND)
unnamed: C6.2, M3.1 (GND), M3.7 (GND)
unnamed: C8.2, M5.1 (GND), M5.7 (GND)
unnamed: C10.2, M7.1 (GND), M7.7 (GND)
unnamed: C12.2, M2.1 (GND), M2.7 (GND)
unnamed: C14.2, M4.1 (GND), M4.7 (GND)
unnamed: C16.2, M6.1 (GND), M6.7 (GND)
unnamed: C18.1, C20.1, IC3.11 (VDD), IC3.32 (VDD)
unnamed: C18.2, C20.2
unnamed: C19.1, Cn3.5
unnamed: C21.1, C54.2, Cn7.2, D3.2 (A), IC2.2 (GND)
unnamed: C28.1, Cn13.2, D15.2 (A)
unnamed: C29.1, C33.2
unnamed: C43.2, C44.2, C45.2, Cn1.2, IC1.2 (GND)
unnamed: Cn1.1, D1.2 (A)
unnamed: Cn2.1, R1.2
unnamed: Cn2.2, R2.2
unnamed: Cn5.2, IC7.11 (O8)
unnamed: Cn5.3, IC7.12 (O7)
unnamed: Cn5.4, IC7.13 (O6)
unnamed: Cn5.5, IC7.14 (O5)
unnamed: Cn6.1, IC7.15 (O4), R14.2
unnamed: Cn8.2, D5.2 (A)
unnamed: Cn9.2, D7.2 (A)
unnamed: Cn10.2, D9.2 (A)
unnamed: Cn11.2, D11.2 (A)
unnamed: Cn12.2, D13.2 (A)
unnamed: Cn14.1, M1.6 (B2)
unnamed: Cn14.2, M1.5 (B1)
unnamed: Cn14.3, M1.3 (A2)
unnamed: Cn14.4, M1.4 (A1)
unnamed: Cn15.1, M2.6 (B2)
unnamed: Cn15.2, M2.5 (B1)
unnamed: Cn15.3, M2.3 (A2)
unnamed: Cn15.4, M2.4 (A1)
unnamed: Cn16.1, M3.6 (B2)
unnamed: Cn16.2, M3.5 (B1)
unnamed: Cn16.3, M3.3 (A2)
unnamed: Cn16.4, M3.4 (A1)
unnamed: Cn17.1, M4.6 (B2)
unnamed: Cn17.2, M4.5 (B1)
unnamed: Cn17.3, M4.3 (A2)
unnamed: Cn17.4, M4.4 (A1)
unnamed: Cn18.1, M5.6 (B2)
unnamed: Cn18.2, M5.5 (B1)
unnamed: Cn18.3, M5.3 (A2)
unnamed: Cn18.4, M5.4 (A1)
unnamed: Cn19.1, M6.6 (B2)
unnamed: Cn19.2, M6.5 (B1)
unnamed: Cn19.3, M6.4 (A1)
unnamed: Cn19.4, M6.3 (A2)
unnamed: Cn20.1, M7.6 (B2)
unnamed: Cn20.2, M7.5 (B1)
unnamed: Cn20.3, M7.4 (A1)
unnamed: Cn20.4, M7.3 (A2)
unnamed: IC3.3 (RA1/AN1), JP1.1 (A), R19.1
unnamed: IC3.12 (VSS), IC3.31 (VSS)
unnamed: IC5.2, R3.2
unnamed: IC5.6, R21.1, U4.1, U4.2
unnamed: IC6.3, R2.1
unnamed: M1.13 (~RST), M1.14 (~SLP)
unnamed: M2.13 (~RST), M2.14 (~SLP)
unnamed: M3.13 (~RST), M3.14 (~SLP)
unnamed: M4.13 (~RST), M4.14 (~SLP)
unnamed: M5.13 (~RST), M5.14 (~SLP)
unnamed: M6.13 (~RST), M6.14 (~SLP)
unnamed: M7.13 (~RST), M7.14 (~SLP)
unnamed: R1.1, U4.3
RX: IC3.26 (DT/RX/RC7), IC6.6, R14.2
SX: IC3.20 (C1IN-/PSP1/RD1), M2.15 (STEP), M3.15 (STEP)
SY4: M6.15 (STEP), M7.15 (STEP)
SYL: IC3.17 (CCP1/RC2), M4.15 (STEP), M5.15 (STEP)
SYR: IC3.18 (SCL/SCK/RC3)
SZ: IC3.7 (RA5/ANA4/~SS/HLVDIN), M1.15 (STEP)
TX: IC3.25 (CK/TX/RC6), R3.1
VMOT: C3.2, C5.2, C7.2, C9.2, C11.2, C13.2, C15.2, C45.1, C47.1, C48.1, C49.1, C50.1, C51.1, C52.1, C53.1, D1.1 (K), D2.2 (A), IC1.1 (VI), IC2.1 (IN), M1.8 (VMOT), M2.8 (VMOT), M3.8 (VMOT), M4.8 (VMOT), M5.8 (VMOT), M6.8 (VMOT), M7.8 (VMOT)

Notes on the sheet:
Corner switches all diodes 1N4148, all capacitors 100nf
3 Gnd PC
1 RX yellow
FTDI 5V TTL cable:
X2Y4Z schematic
-GND
2 TX orange
LASER
FAN
4 +5V PC
RESET
+DC 12..24V
